cadcatcam/caudalimetroO2_velarde/caudalimetro_principal.SLDASM

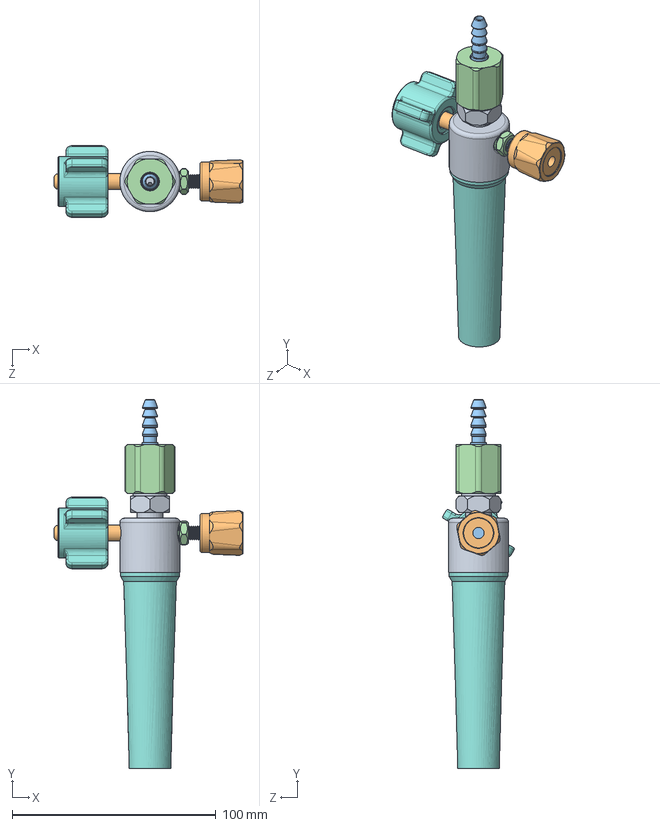
[picture p5: CAD file, 2025-07-04]
caudalimetro_principal.SLDASM
92.7 x 181.0 x 35.1 mm
Cuerpo central
Cilindro de conexión entrada
Cilindro de conexión salida
Tuerca capuchón salida
Cilindro interno
Tapa ahujereada cilindros
esfera
Cilindro exterior
Oring grande
tuerca_valvula
tornillo_perilla_válvula
tuerca_de_perilla_valvula
Niple perilla
vastago_asiento_perilla_válvula
Oring chico x 3
Tuerca conexión alimentador
