cadcatcam/caudalimetroO2_velarde/Perilla reguladora.SLDASM

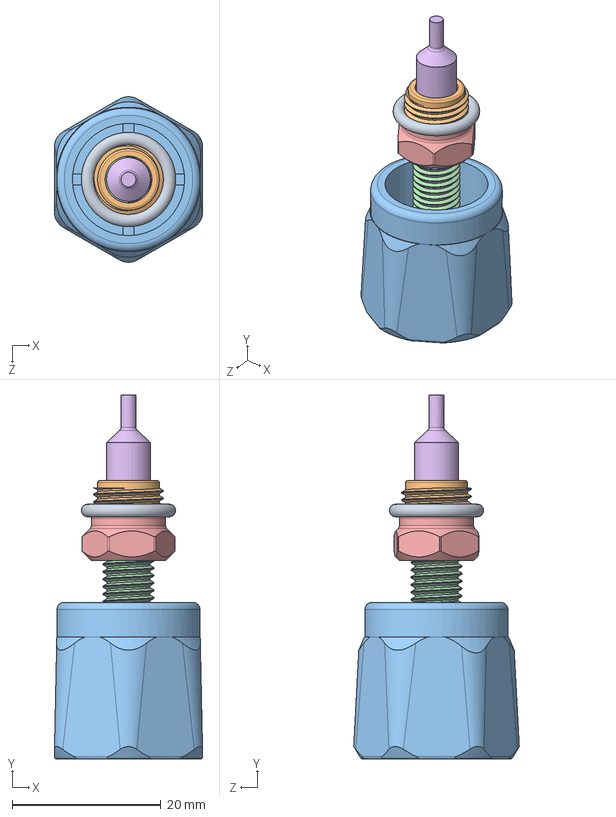
[picture p6: CAD file, 2025-07-04]
Perilla reguladora.SLDASM
20.0 x 49.0 x 22.3 mm
tuerca_valvula
tornillo_perilla_válvula
tuerca_de_perilla_valvula
Niple perilla
vastago_asiento_perilla_válvula
Oring chico
