cadcatcam/caudalimetroO2_velarde/Ensamblaje de cilindros.SLDASM

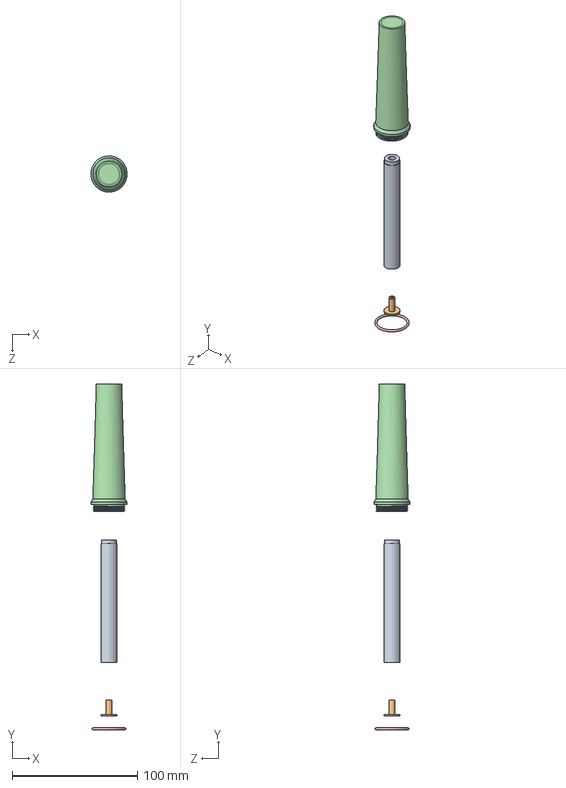
[picture p7: CAD file, 2025-07-04]
Ensamblaje de cilindros.SLDASM
29.0 x 276.0 x 29.0 mm
Cilindro interno
Tapa ahujereada cilindros
esfera
Cilindro exterior
Oring grande
