cadcatcam/caudalimetroO2_velarde/Cilindro de conexión entrada.SLDPRT

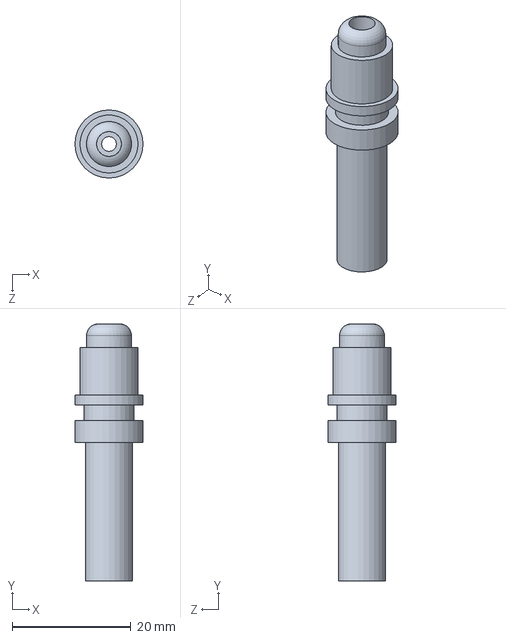
[picture p8: CAD file, 2025-07-04]
Cilindro de conexión entrada.SLDPRT
11.5 x 43.4 x 11.5 mm
