cadcatcam/caudalimetroO2_velarde/Cilindro de conexión salida.SLDPRT

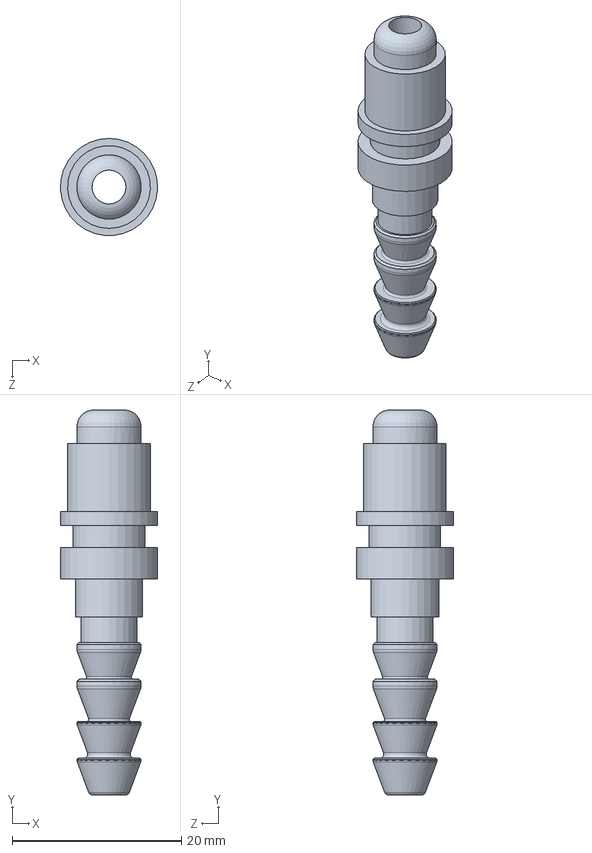
[picture p9: CAD file, 2025-07-04]
Cilindro de conexión salida.SLDPRT
11.5 x 45.5 x 11.5 mm
