cadcatcam/caudalimetroO2_velarde/tuerca_de_perilla_valvula.SLDPRT

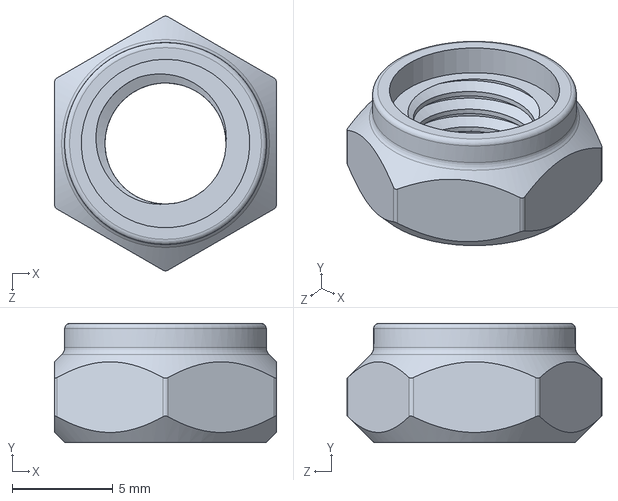
[picture p10: CAD file, 2025-07-04]
tuerca_de_perilla_valvula.SLDPRT
11.0 x 5.90 x 12.6 mm
