cadcatcam/caudalimetroO2_velarde/Oring chico.SLDPRT

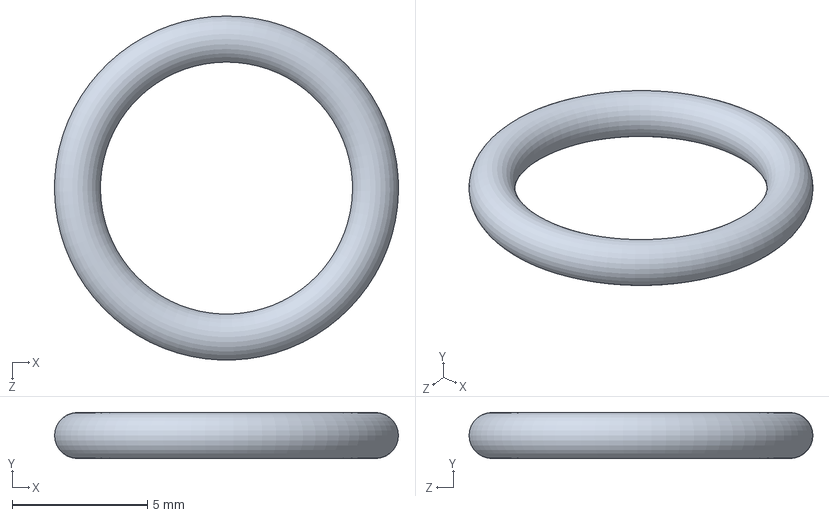
[picture p11: CAD file, 2025-07-04]
Oring chico.SLDPRT
12.7 x 1.70 x 12.7 mm
