cadcatcam/caudalimetroO2_velarde/tuerca_valvula.SLDPRT

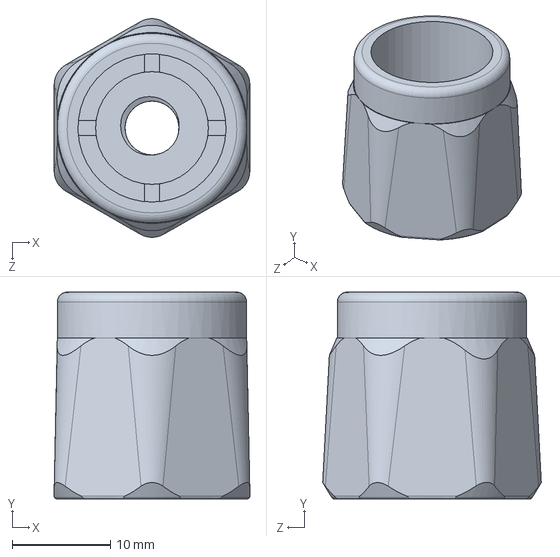
[picture p12: CAD file, 2025-07-04]
tuerca_valvula.SLDPRT
20.0 x 21.1 x 22.3 mm
