cadcatcam/caudalimetroO2_velarde/vastago_asiento_perilla_válvula.SLDPRT

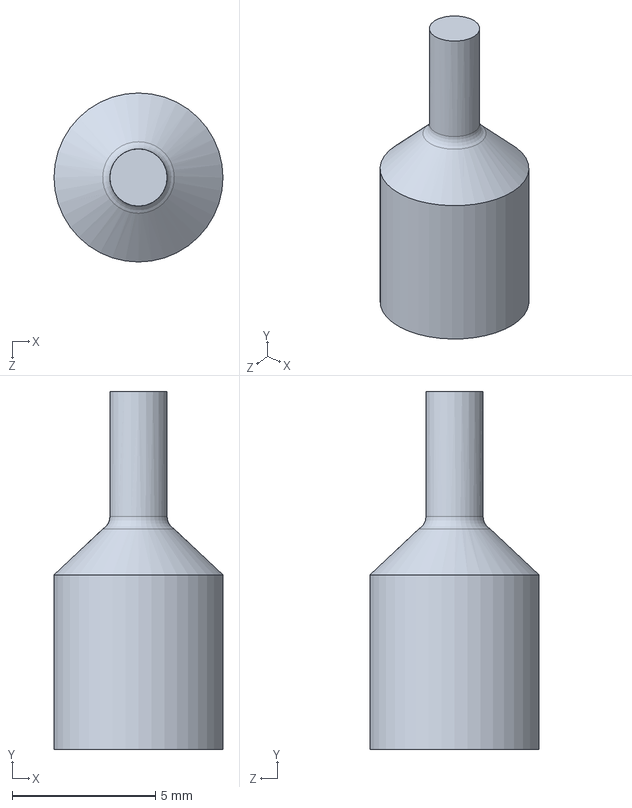
[picture p13: CAD file, 2025-07-04]
vastago_asiento_perilla_válvula.SLDPRT
5.90 x 12.5 x 5.90 mm
