cadcatcam/caudalimetroO2_velarde/Cilindro exterior.SLDPRT

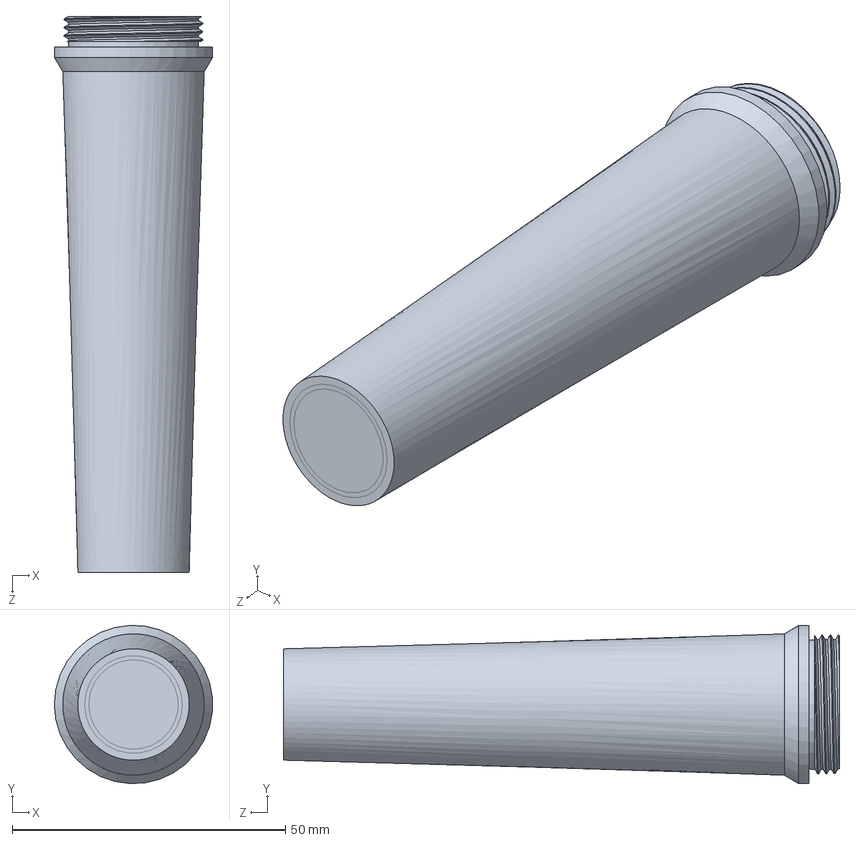
[picture p14: CAD file, 2025-07-04]
Cilindro exterior.SLDPRT
29.0 x 29.0 x 101.8 mm
