cadcatcam/caudalimetroO2_velarde/Tuerca conexión alimentador.SLDPRT

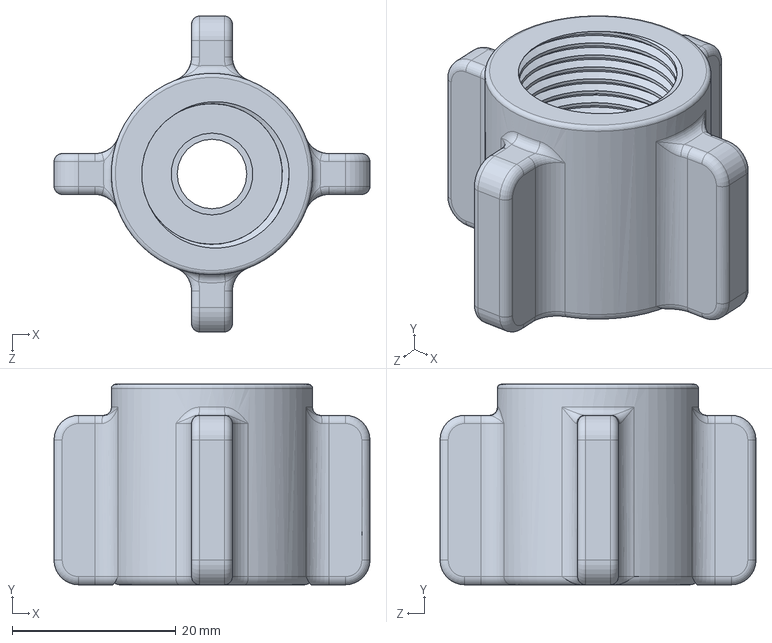
[picture p15: CAD file, 2025-07-04]
Tuerca conexión alimentador.SLDPRT
38.6 x 24.5 x 38.6 mm
