cadcatcam/caudalimetroO2_velarde/Tapa ahujereada cilindros.SLDPRT

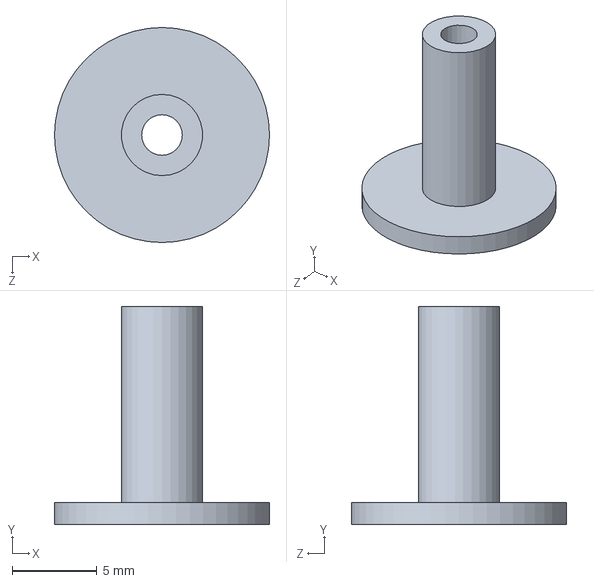
[picture p16: CAD file, 2025-07-04]
Tapa ahujereada cilindros.SLDPRT
12.7 x 12.9 x 12.7 mm
