cadcatcam/caudalimetroO2_velarde/Oring grande.SLDPRT

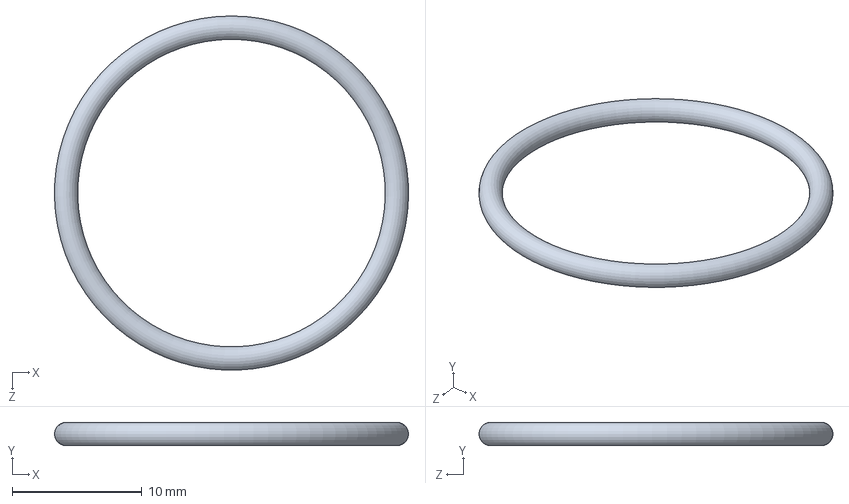
[picture p17: CAD file, 2025-07-04]
Oring grande.SLDPRT
27.3 x 1.80 x 27.3 mm
