cadcatcam/caudalimetroO2_velarde/Cuerpo central.SLDPRT

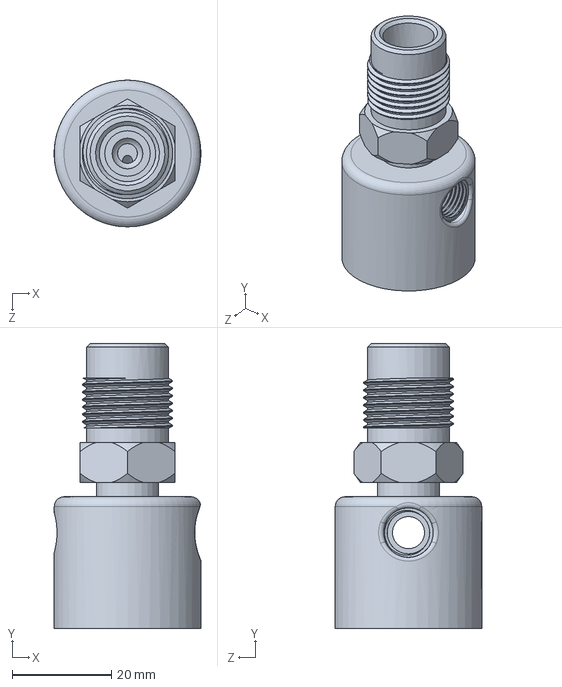
[picture p18: CAD file, 2025-07-04]
Cuerpo central.SLDPRT
29.6 x 57.5 x 29.6 mm
