cadcatcam/caudalimetroO2_velarde/Cilindro interno.SLDPRT

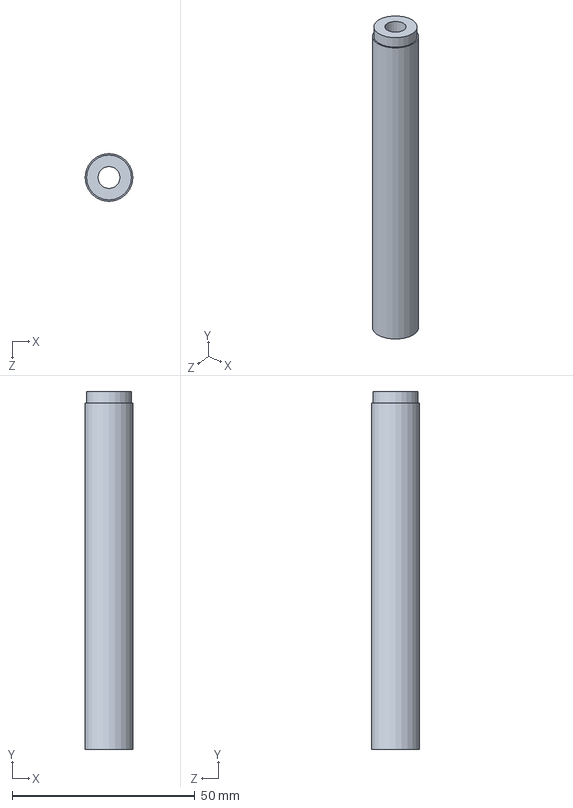
[picture p19: CAD file, 2025-07-04]
Cilindro interno.SLDPRT
13.1 x 98.0 x 13.1 mm
