cadcatcam/caudalimetroO2_velarde/Niple perilla.SLDPRT

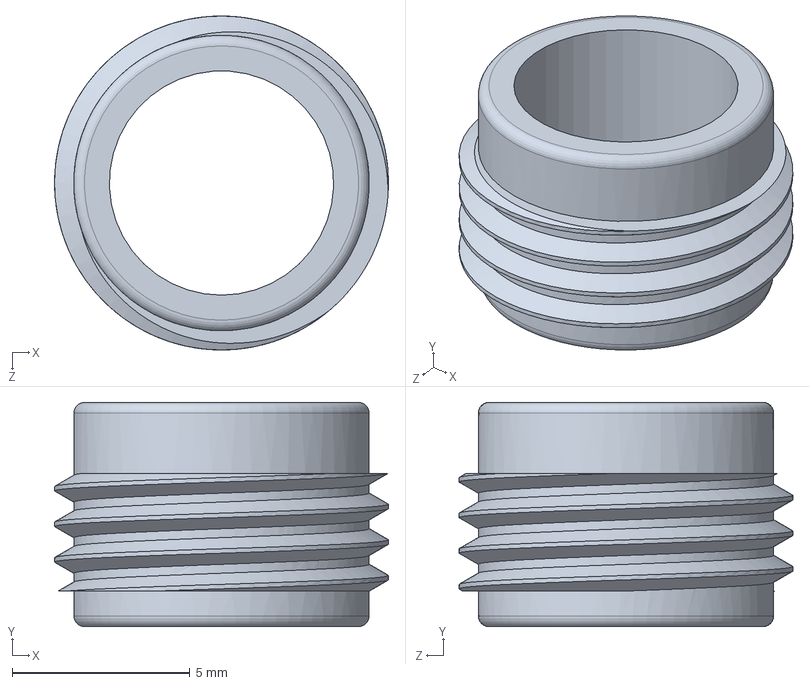
[picture p20: CAD file, 2025-07-04]
Niple perilla.SLDPRT
9.38 x 6.30 x 9.38 mm
