cadcatcam/caudalimetroO2_velarde/esfera.SLDPRT

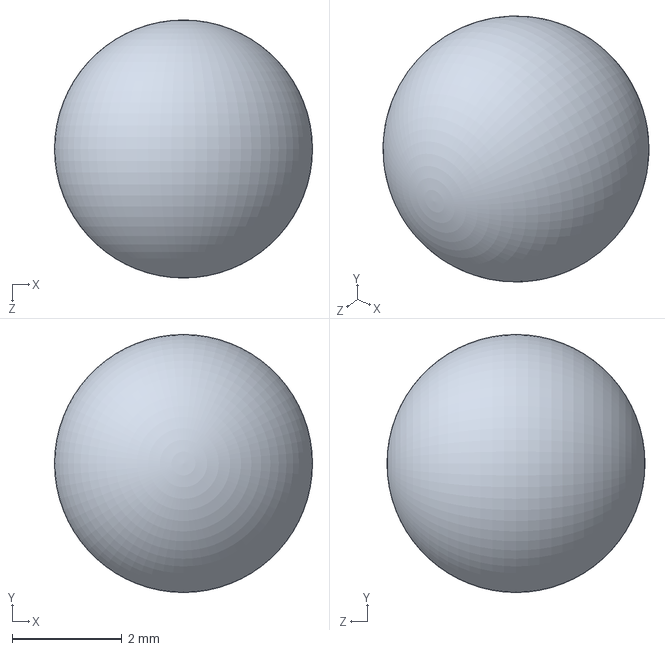
[picture p21: CAD file, 2025-07-04]
esfera.SLDPRT
4.70 x 4.70 x 4.70 mm
