cadcatcam/caudalimetroO2_velarde/Tuerca capuchón salida.SLDPRT

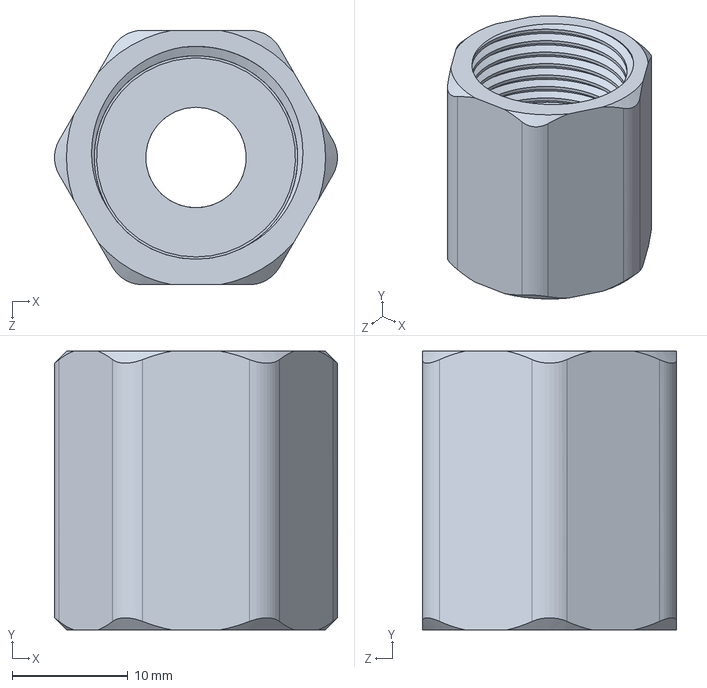
[picture p22: CAD file, 2025-07-04]
Tuerca capuchón salida.SLDPRT
24.5 x 24.1 x 22.0 mm
