cadcatcam/caudalimetroO2_velarde/tornillo_perilla_válvula.SLDPRT

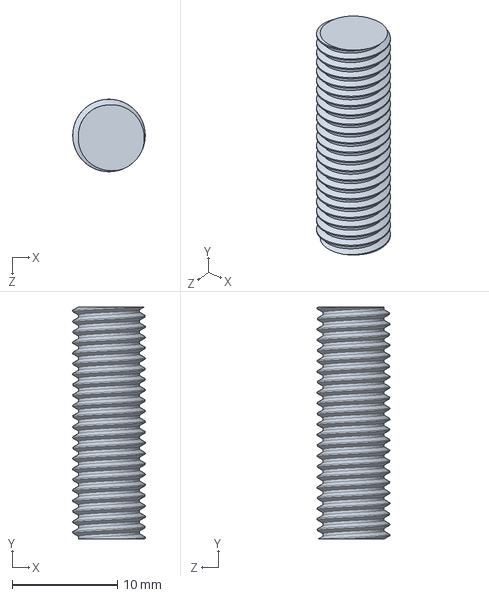
[picture p23: CAD file, 2025-07-04]
tornillo_perilla_válvula.SLDPRT
6.88 x 22.0 x 6.88 mm
