cadcatcam/caudalimetroO2_velarde/tuerca_externa_con_nervios.SLDPRT

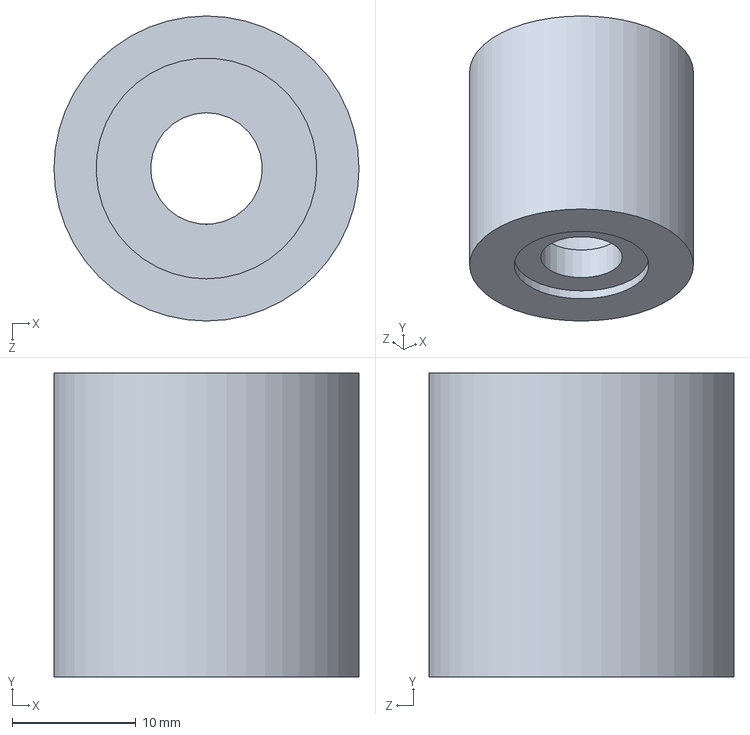
[picture p24: CAD file, 2025-06-27]
tuerca_externa_con_nervios.SLDPRT
24.6 x 24.5 x 24.6 mm
