cadcatcam/caudalimetroO2_velarde/tuerca_capuchon_v2_2020.SLDPRT

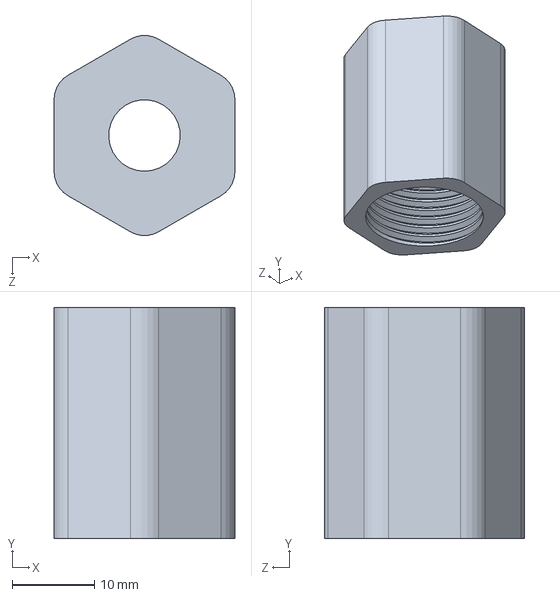
[picture p25: CAD file, 2025-05-26]
tuerca_capuchon_v2_2020.SLDPRT
22.0 x 28.1 x 24.3 mm
