cadcatcam/caudalimetroO2_velarde/tuerca_capuchon.SLDPRT

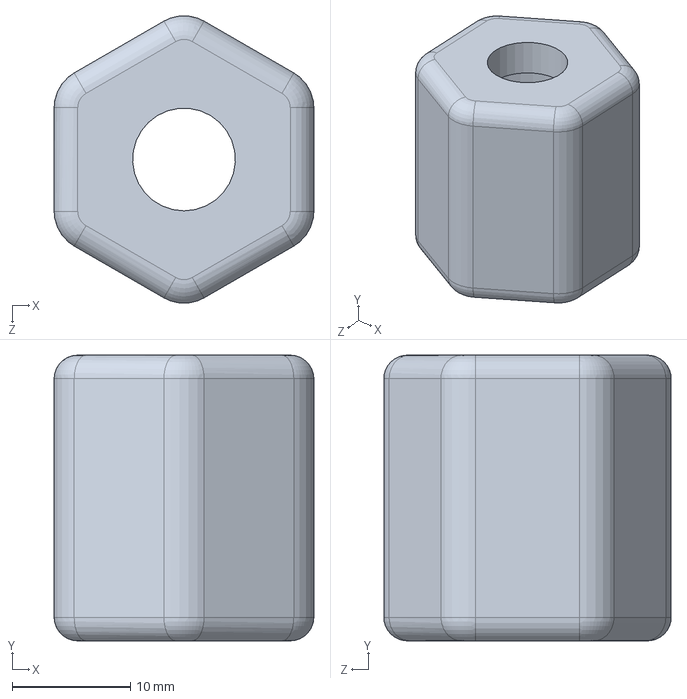
[picture p26: CAD file, 2025-05-23]
tuerca_capuchon.SLDPRT
22.0 x 24.2 x 24.3 mm
