cadcatcam/caudalimetroO2_velarde/oring.SLDPRT

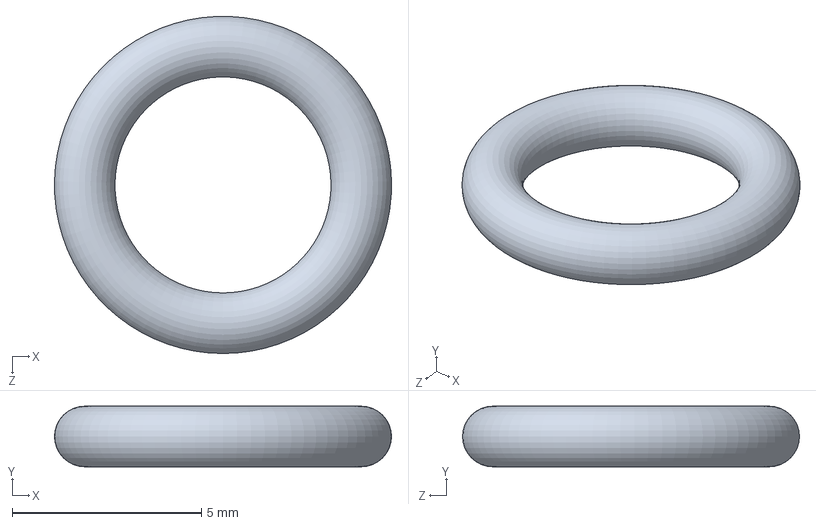
[picture p27: CAD file, 2025-04-24]
oring.SLDPRT
8.90 x 1.60 x 8.90 mm
