cadcatcam/caudalimetroO2_velarde/tapon.SLDPRT

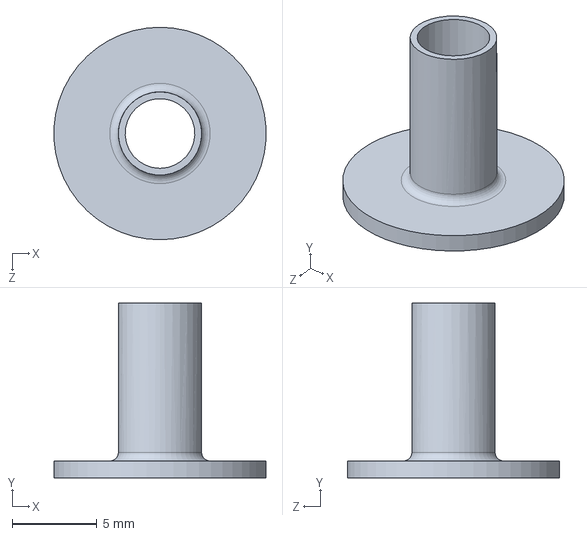
[picture p28: CAD file, 2025-04-24]
tapon.SLDPRT
12.5 x 10.3 x 12.5 mm
