cadcatcam/caudalimetroO2_velarde/Esfera_2020.SLDPRT

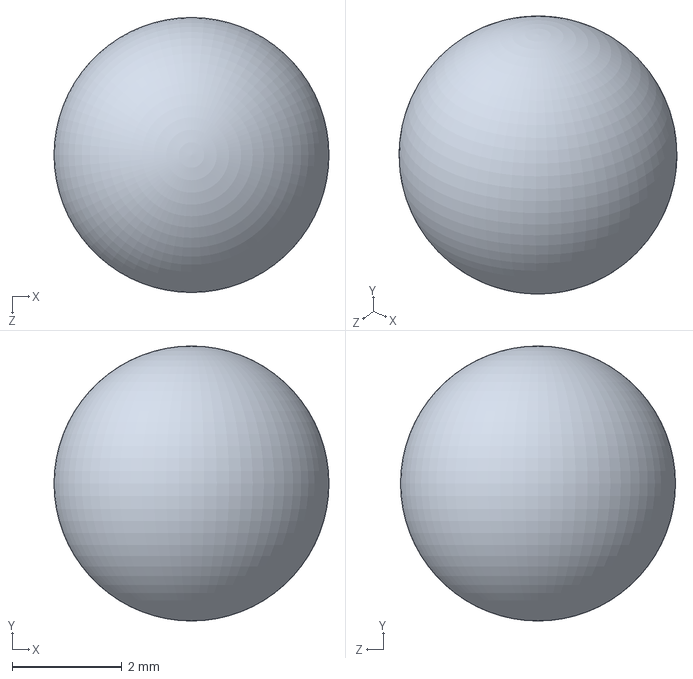
[picture p29: CAD file, 2025-04-24]
Esfera_2020.SLDPRT
5.00 x 5.00 x 5.00 mm
