cadcatcam/caudalimetroO2_velarde/(list of files, cad)

Other CAD files:
planos/caudalimetro_perilla.SLDDRW
planos/caudalimetro_principal.SLDDRW
planos/cilindro_interno.SLDDRW
planos/cilindro_rosca_externa_perilla_válvula.SLDDRW
planos/esfera_2018.SLDDRW
planos/oring_chico.SLDDRW
planos/tapon_2018.SLDDRW
planos/vastago_asiento_perilla_válvula.SLDDRW
