cadcatcam/caudalimetroO2_velarde/planos/caudalimetro_principal_muchas_hojas.pdf

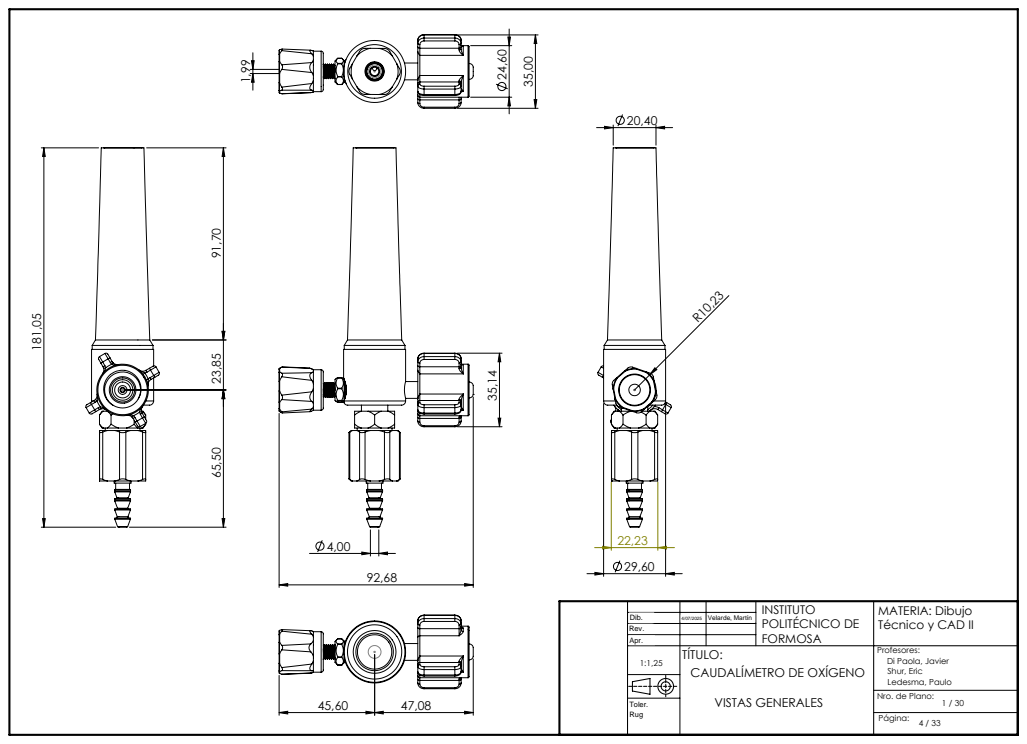
[picture p30: page 1]
POLITÉCNICO DE

MATERIA: Dibujo
Técnico y CAD II

CAUDALÍMETRO DE OXÍGENO
VISTAS GENERALES

Di Paola, Javier
Shur, Eric
Ledesma, Paulo
Nro. de Plano:

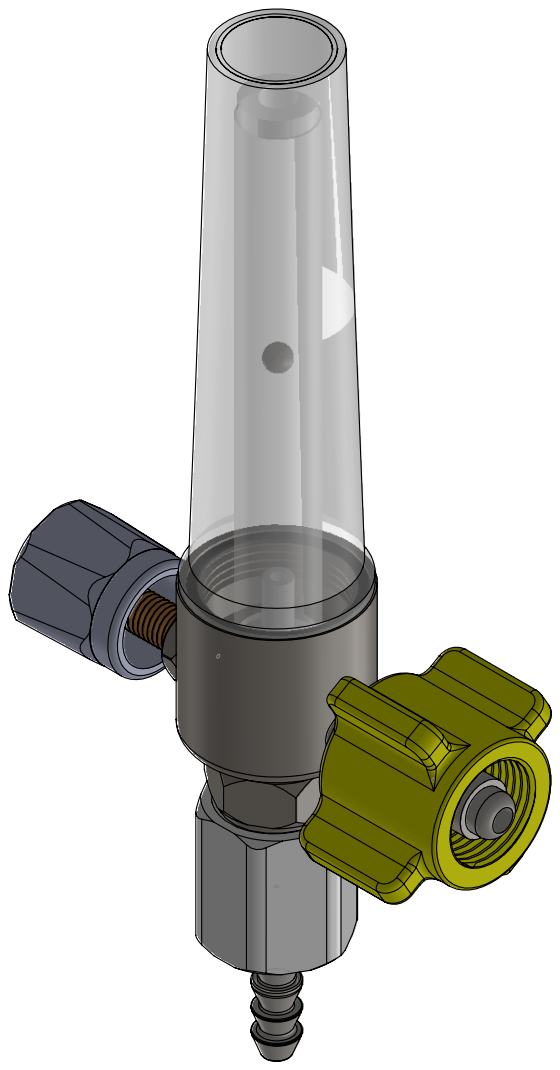
[picture p31: page 2]
POLITÉCNICO DE

MATERIA: Dibujo
Técnico y CAD II

CAUDALÍMETRO DE OXÍGENO
PERSPECTIVA GENERAL 1

Di Paola, Javier
Shur, Eric
Ledesma, Paulo
Nro. de Plano:

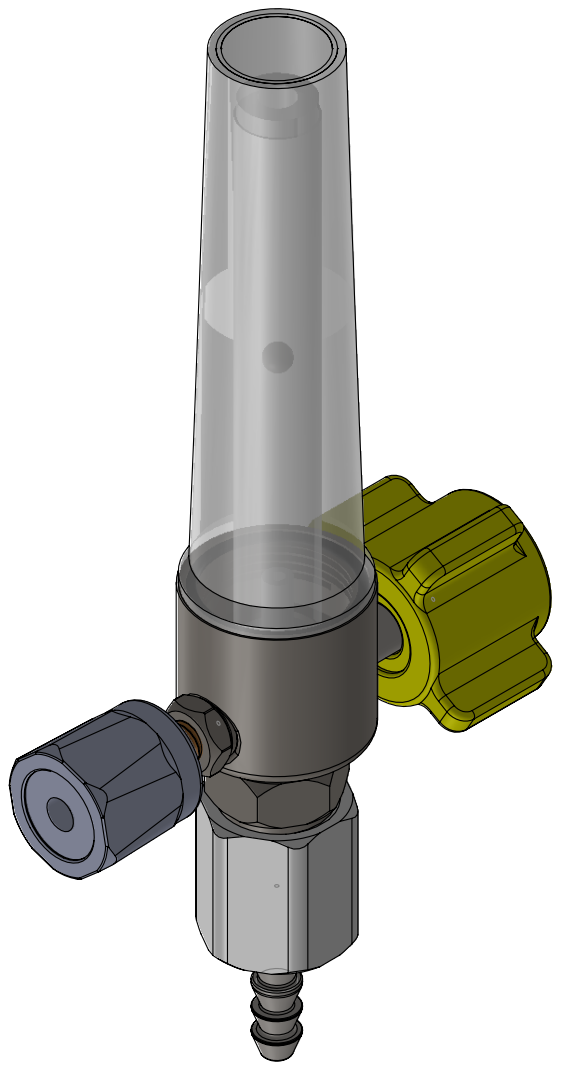
[picture p32: page 3]
POLITÉCNICO DE

MATERIA: Dibujo
Técnico y CAD II

CAUDALÍMETRO DE OXÍGENO
PERSPECTIVA GENERAL 2

Di Paola, Javier
Shur, Eric
Ledesma, Paulo
Nro. de Plano:

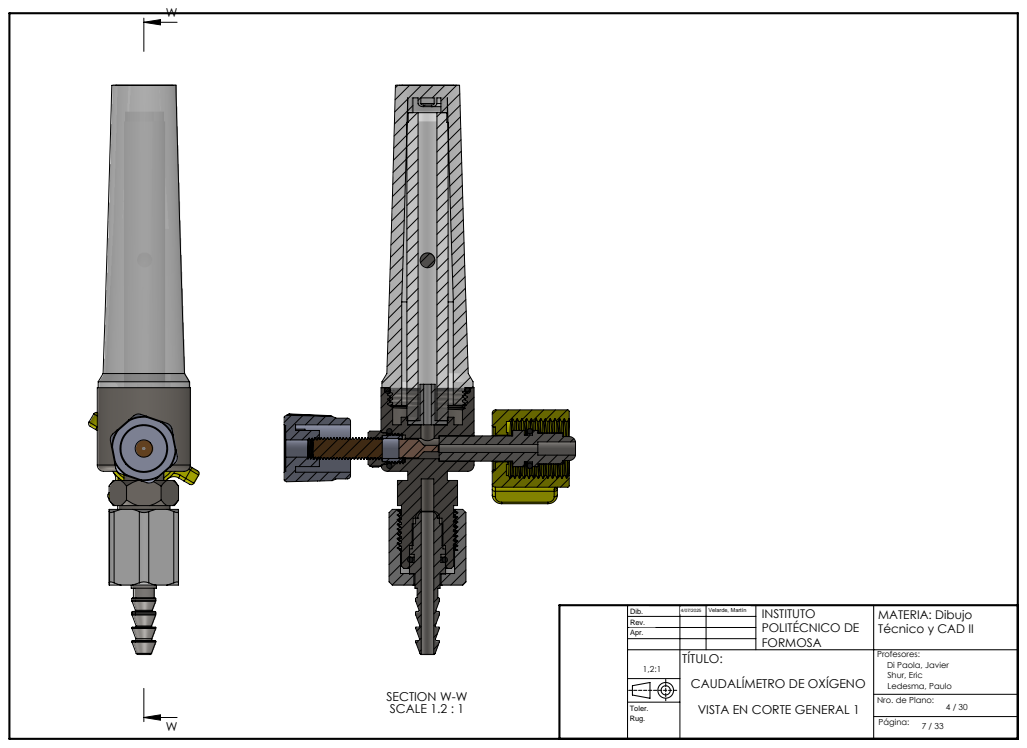
[picture p33: page 4]
SECTION W-W; SCALE 1.2 : 1; VISTA EN CORTE GENERAL 1; POLITÉCNICO DE

MATERIA: Dibujo
Técnico y CAD II

CAUDALÍMETRO DE OXÍGENO

Di Paola, Javier
Shur, Eric
Ledesma, Paulo
Nro. de Plano:

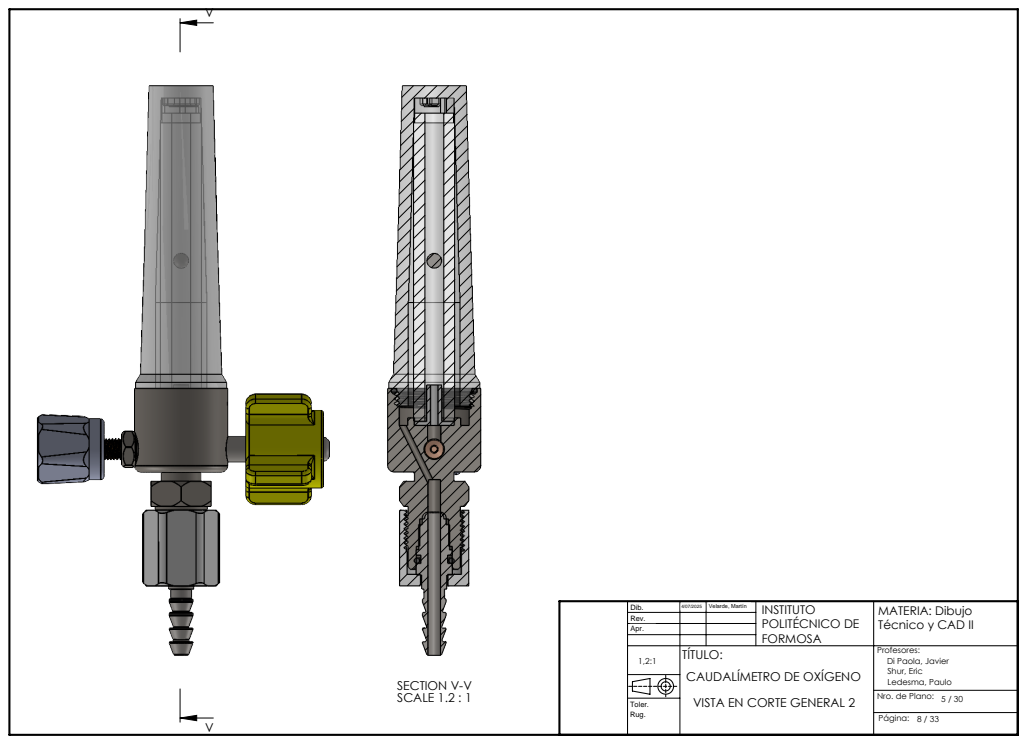
[picture p34: page 5]
SECTION V-V SCALE 1.2 : 1; POLITÉCNICO DE

MATERIA: Dibujo
Técnico y CAD II

CAUDALÍMETRO DE OXÍGENO
5 / 30 VISTA EN CORTE GENERAL 2

Di Paola, Javier
Shur, Eric
Ledesma, Paulo
Nro. de Plano:

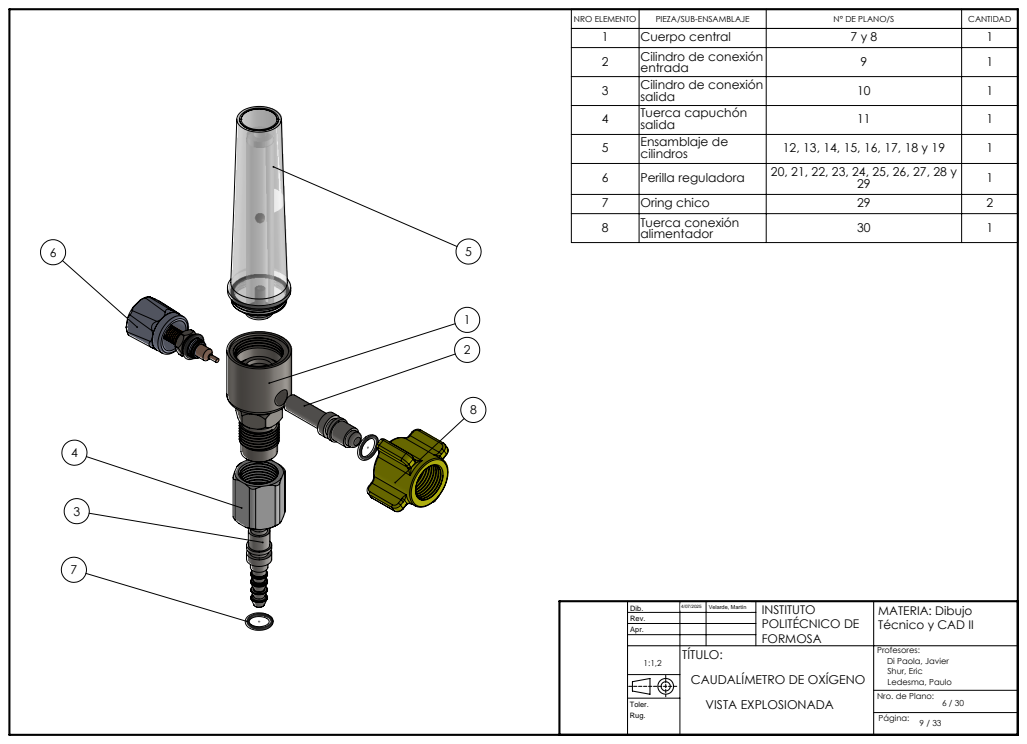
[picture p35: page 6]
POLITÉCNICO DE

NRO ELEMENTO | PIEZA/SUB-ENSAMBLAJE | N° DE PLANO/S | CANTIDAD
1 | Cuerpo central | 7 y 8 | 1
2 | Cilindro de conexión entrada | 9 | 1
3 | Cilindro de conexión salida | 10 | 1
4 | Tuerca capuchón salida | 11 | 1
5 | Ensamblaje de cilindros | 12, 13, 14, 15, 16, 17, 18 y 19 | 1
6 | Perilla reguladora | 20, 21, 22, 23, 24, 25, 26, 27, 28 y 29 | 1
7 | Oring chico | 29 | 2
8 | Tuerca conexión alimentador | 30 | 1

MATERIA: Dibujo
Técnico y CAD II

CAUDALÍMETRO DE OXÍGENO
VISTA EXPLOSIONADA

Di Paola, Javier
Shur, Eric
Ledesma, Paulo
Nro. de Plano:

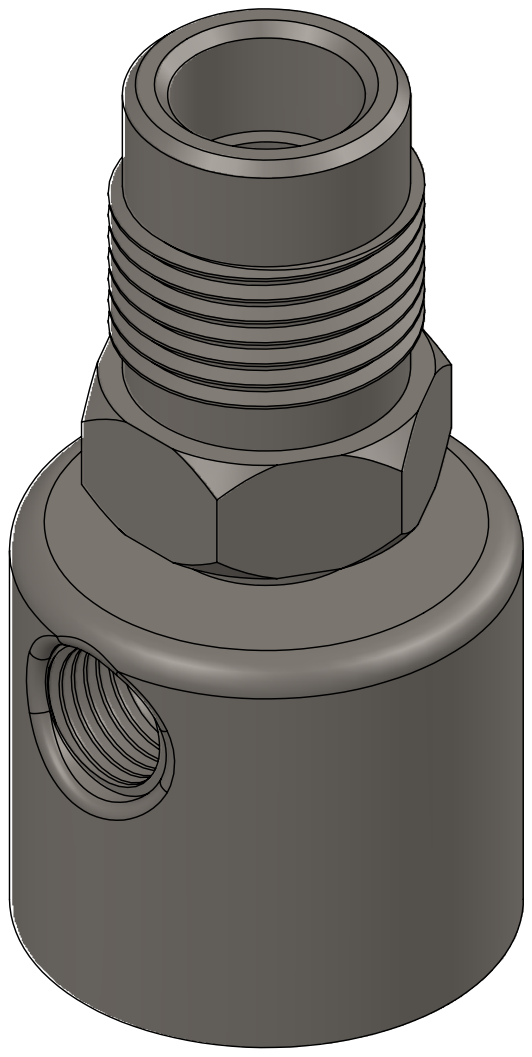
[picture p36: page 7]
CUERPO CENTRAL; POLITÉCNICO DE

MATERIA: Dibujo
Técnico y CAD II

Di Paola, Javier
Shur, Eric
Ledesma, Paulo
Nro. de Plano:

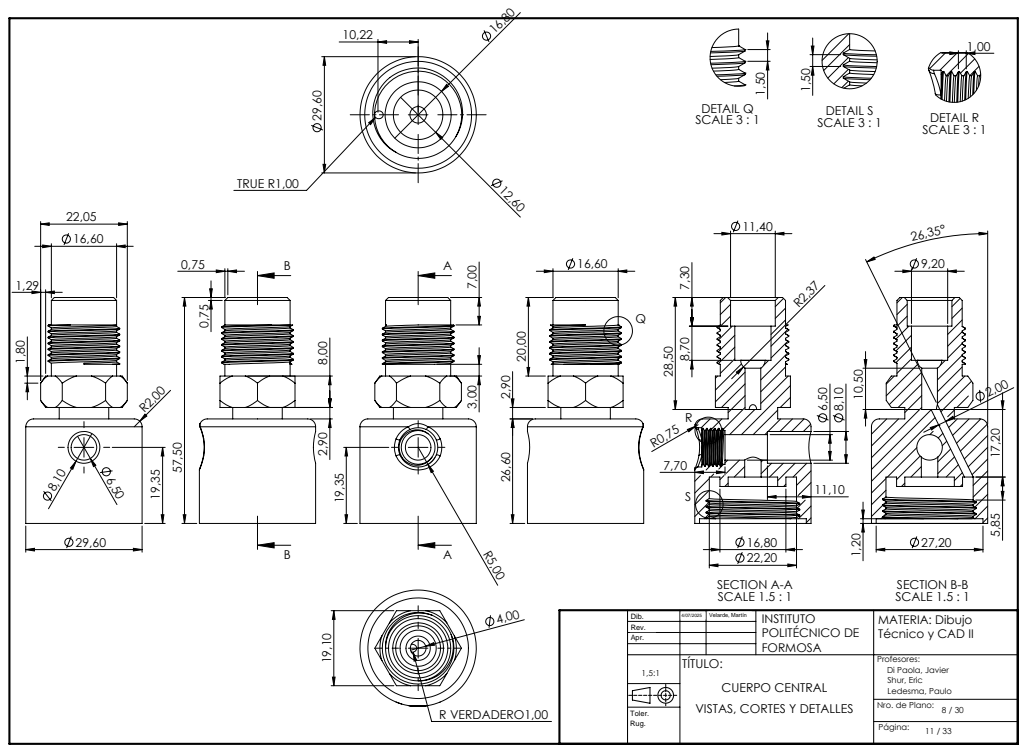
[picture p37: page 8]
TRUE R1,00; R VERDADERO1,00; SECTION A-A SCALE 1.5 : 1; DETAIL Q SCALE 3 : 1; DETAIL R SCALE 3 : 1; DETAIL S SCALE 3 : 1; POLITÉCNICO DE

SECTION B-B
SCALE 1.5 : 1
MATERIA: Dibujo
Técnico y CAD II

CUERPO CENTRAL
VISTAS, CORTES Y DETALLES

Di Paola, Javier
Shur, Eric
Ledesma, Paulo
Nro. de Plano:

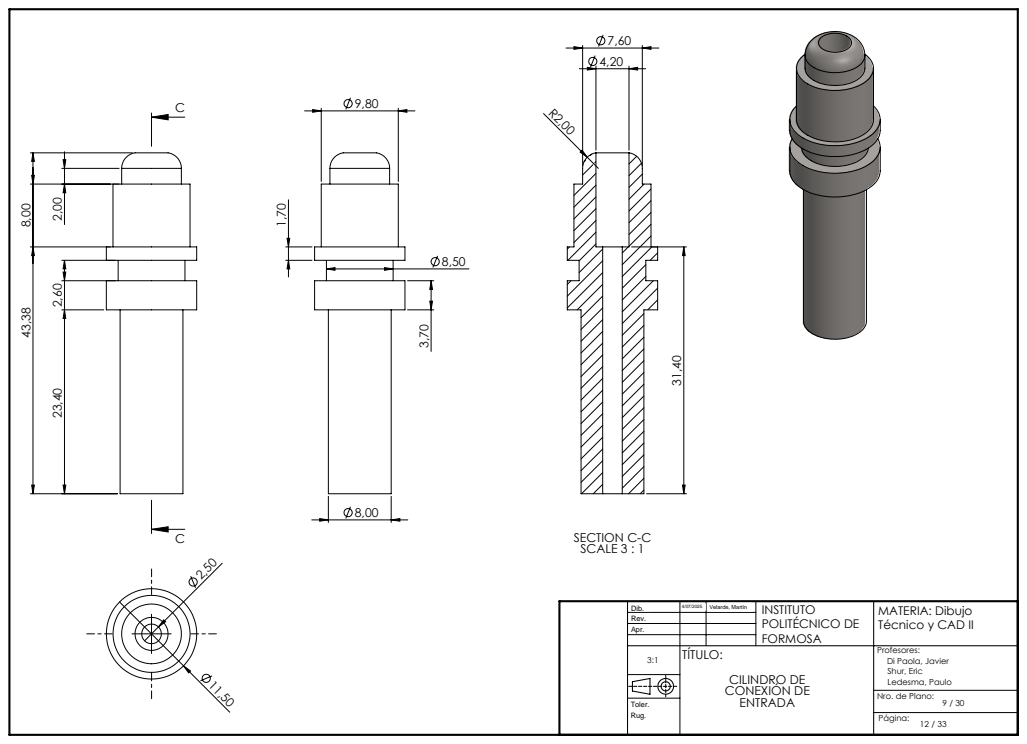
[picture p38: page 9]
SECTION C-C SCALE 3 : 1; CILINDRO DE CONEXIÓN DE; POLITÉCNICO DE

MATERIA: Dibujo
Técnico y CAD II

Di Paola, Javier
Shur, Eric
Ledesma, Paulo
Nro. de Plano:

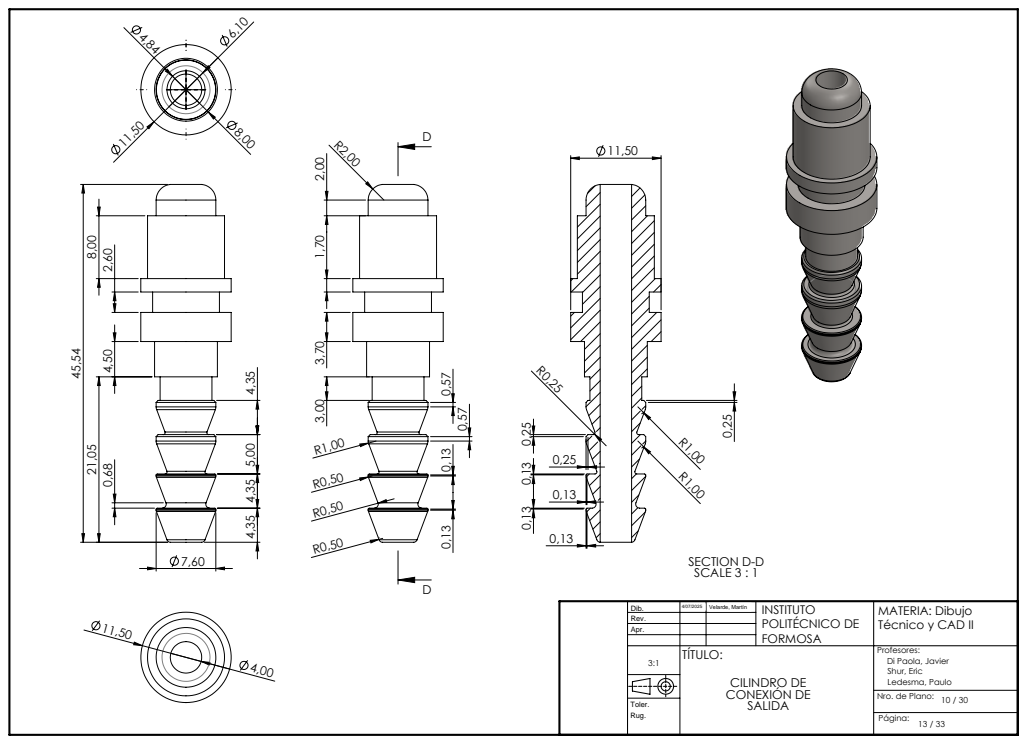
[picture p39: page 10]
SECTION D-D SCALE 3 : 1; CILINDRO DE CONEXIÓN DE; POLITÉCNICO DE

MATERIA: Dibujo
Técnico y CAD II

Di Paola, Javier
Shur, Eric
Ledesma, Paulo
Nro. de Plano:

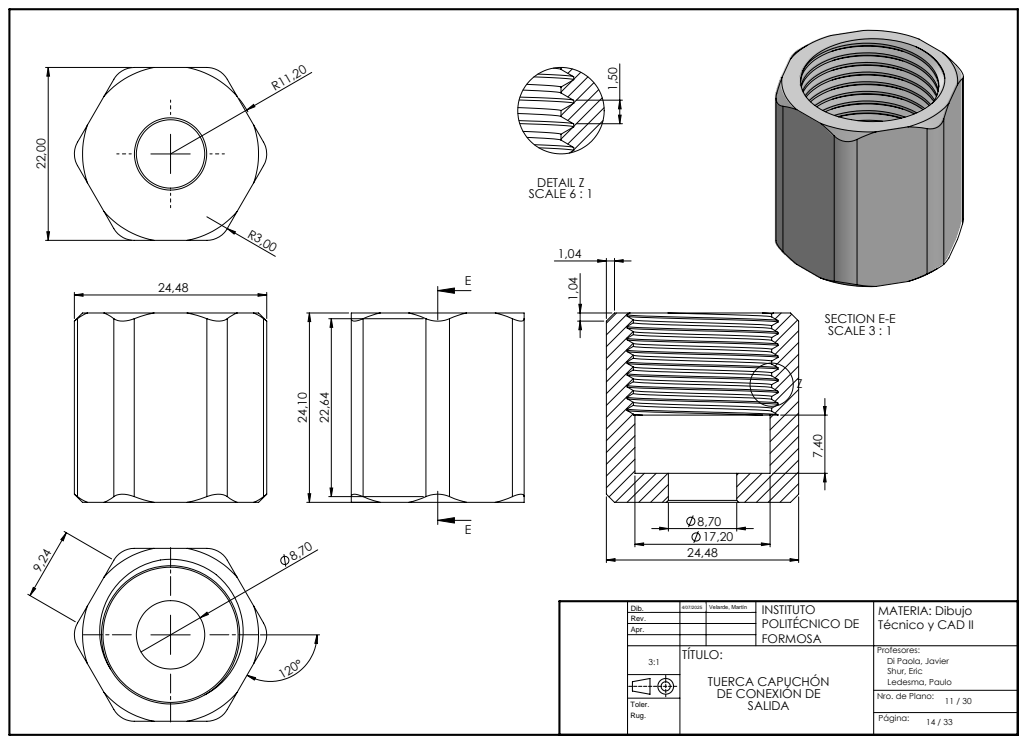
[picture p40: page 11]
SECTION E-E SCALE 3 : 1; DETAIL Z SCALE 6 : 1; POLITÉCNICO DE

MATERIA: Dibujo
Técnico y CAD II

Di Paola, Javier
Shur, Eric
Ledesma, Paulo
Nro. de Plano:

TUERCA CAPUCHÓN
DE CONEXIÓN DE
SALIDA

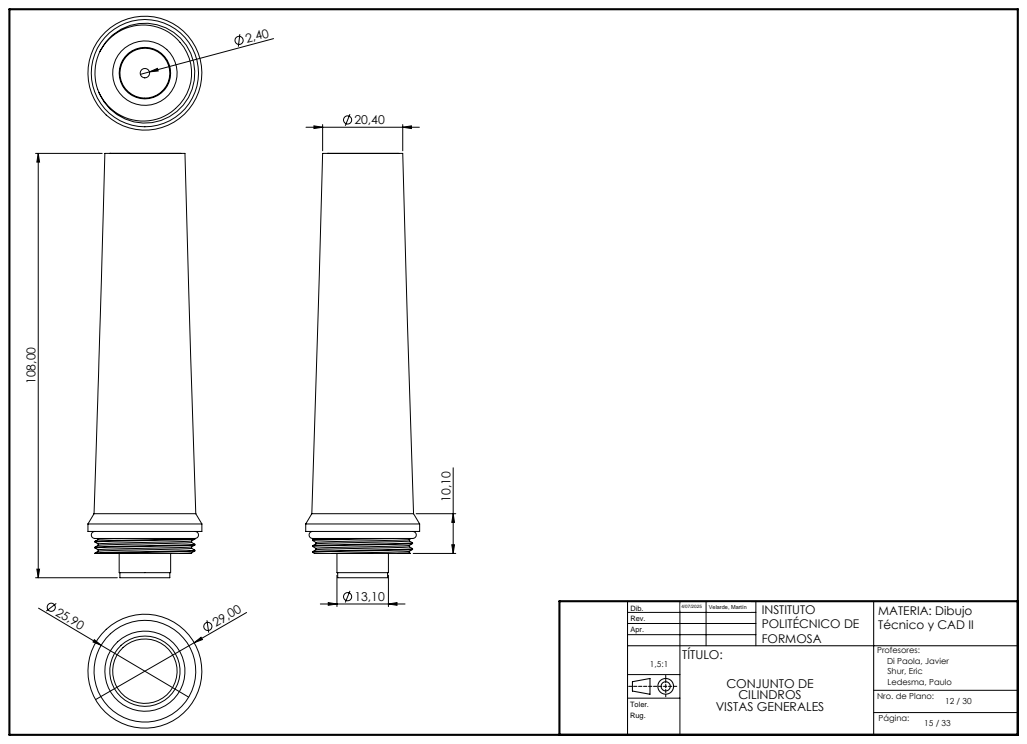
[picture p41: page 12]
CONJUNTO DE VISTAS GENERALES; POLITÉCNICO DE

MATERIA: Dibujo
Técnico y CAD II

Di Paola, Javier
Shur, Eric
Ledesma, Paulo
Nro. de Plano:

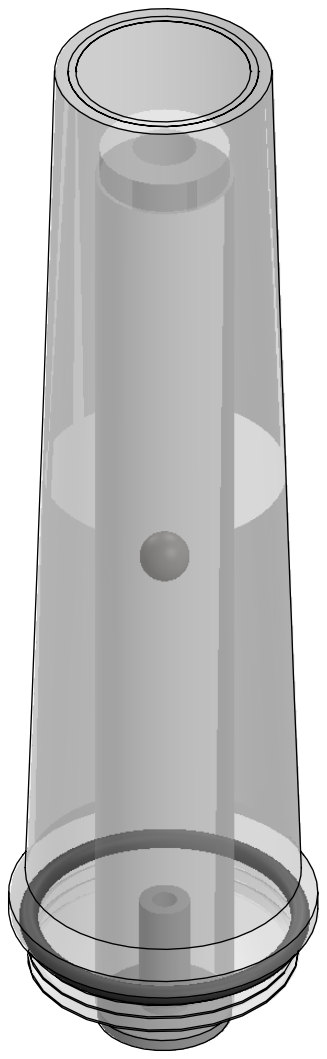
[picture p42: page 13]
CONJUNTO DE; POLITÉCNICO DE

MATERIA: Dibujo
Técnico y CAD II

Di Paola, Javier
Shur, Eric
Ledesma, Paulo
Nro. de Plano:

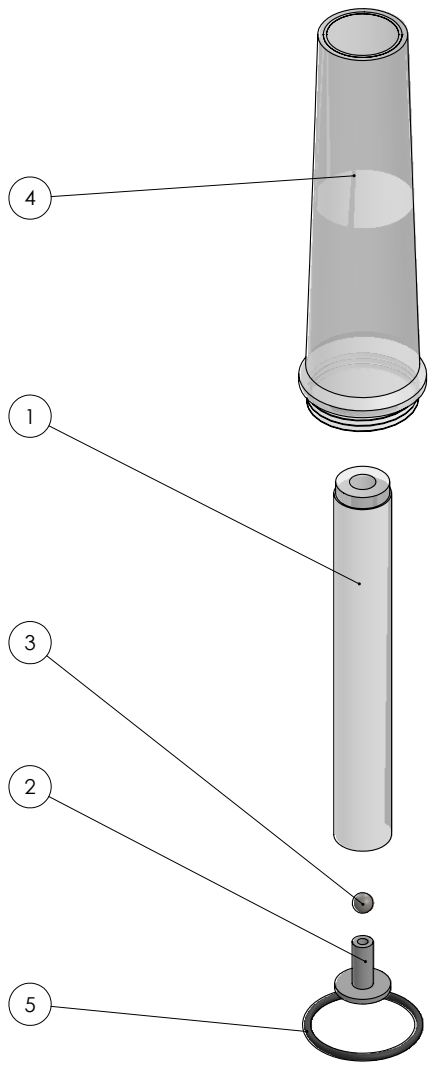
[picture p43: page 14]
CONJUNTO DE VISTA EXPLOSIONADA; POLITÉCNICO DE

NRO ELEMENTO | PIEZA/SUB-ENSAMBLAJE | N° DE PLANO/S | CANTIDAD
1 | Cilindro interno | 15 | 1
2 | Tapa ahujereada cilindros | 16 | 1
3 | Esfera | 17 | 1
4 | Cilindro exterior | 18 | 1
5 | Oring grande | 19 | 1

MATERIA: Dibujo
Técnico y CAD II

Di Paola, Javier
Shur, Eric
Ledesma, Paulo
Nro. de Plano:

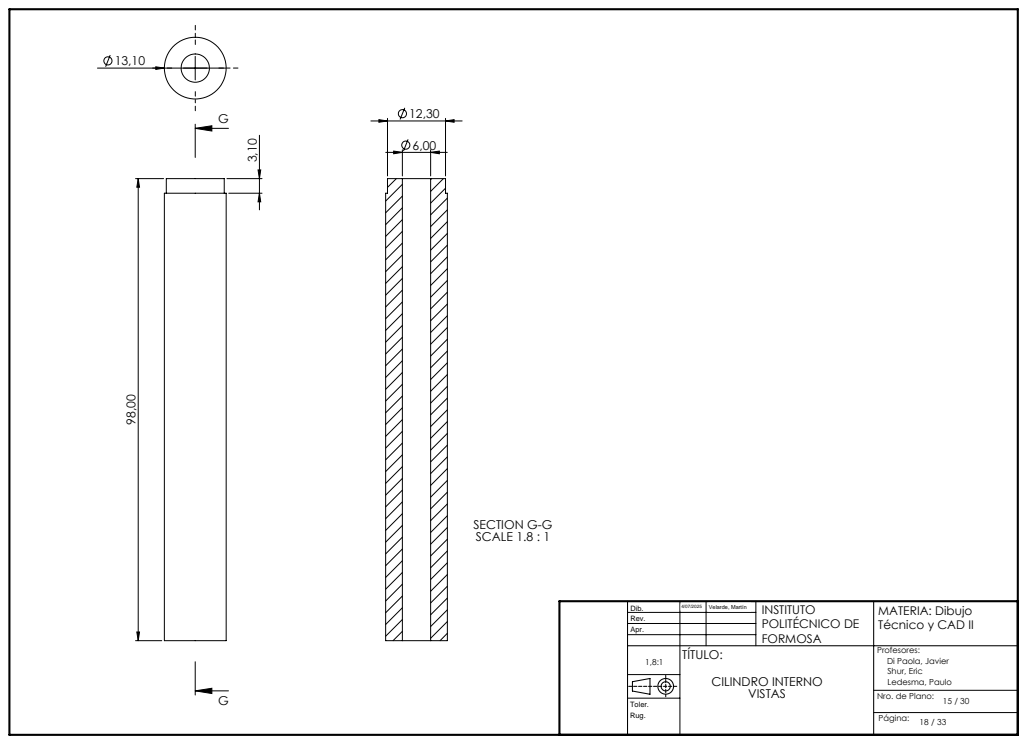
[picture p44: page 15]
SECTION G-G SCALE 1.8 : 1; CILINDRO INTERNO; POLITÉCNICO DE

MATERIA: Dibujo
Técnico y CAD II

Di Paola, Javier
Shur, Eric
Ledesma, Paulo
Nro. de Plano:

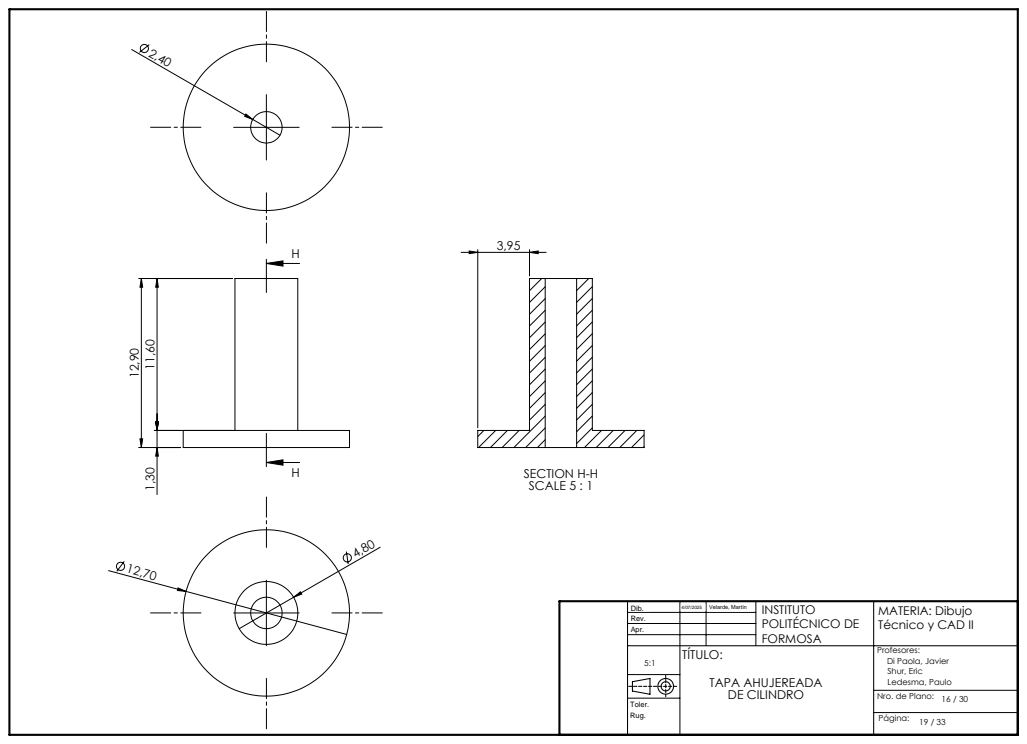
[picture p45: page 16]
SECTION H-H SCALE 5 : 1; TAPA AHUJEREADA DE CILINDRO; POLITÉCNICO DE

MATERIA: Dibujo
Técnico y CAD II

Di Paola, Javier
Shur, Eric
Ledesma, Paulo
Nro. de Plano:

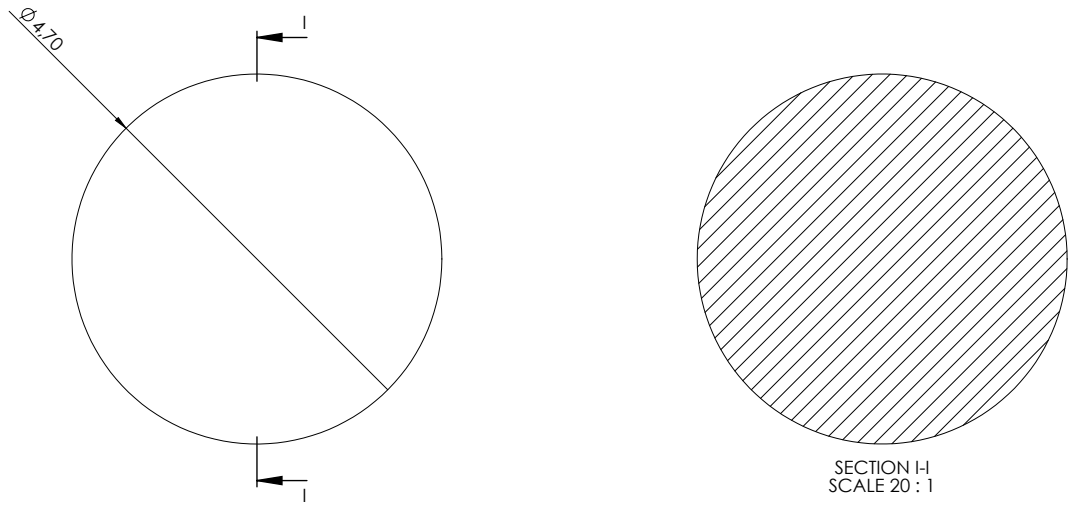
[picture p46: page 17]
SECTION I-I SCALE 20 : 1; POLITÉCNICO DE

MATERIA: Dibujo
Técnico y CAD II

Di Paola, Javier
Shur, Eric
Ledesma, Paulo
Nro. de Plano:

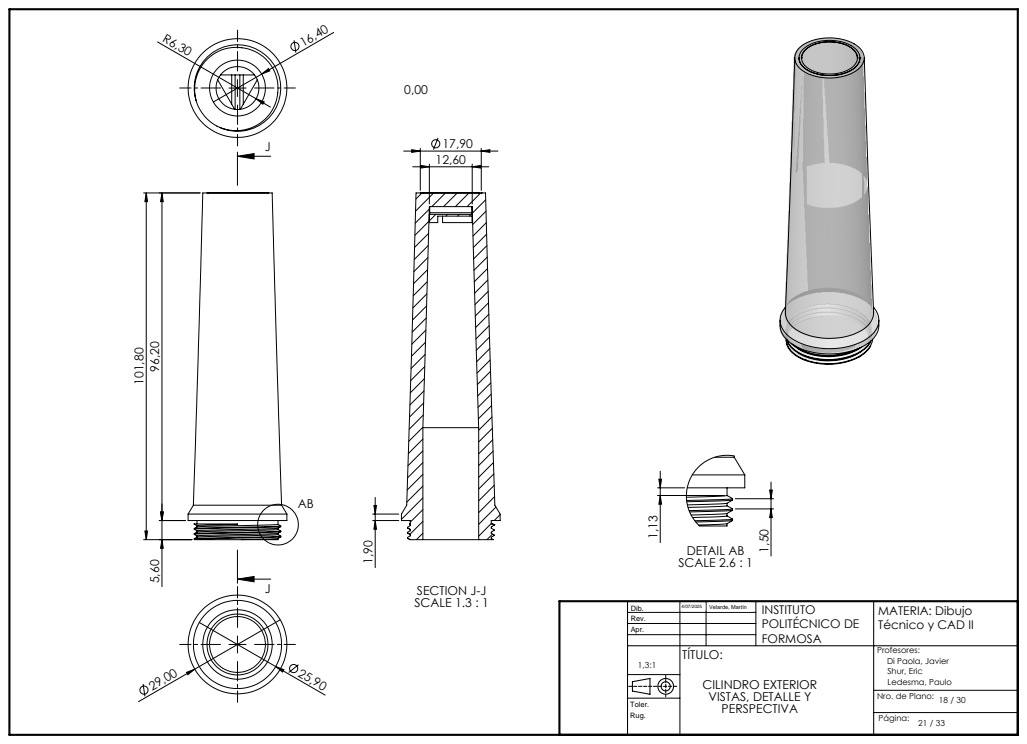
[picture p47: page 18]
SECTION J-J SCALE 1.3 : 1; DETAIL AB SCALE 2.6 : 1; CILINDRO EXTERIOR VISTAS, DETALLE Y; POLITÉCNICO DE

MATERIA: Dibujo
Técnico y CAD II

Di Paola, Javier
Shur, Eric
Ledesma, Paulo
Nro. de Plano:

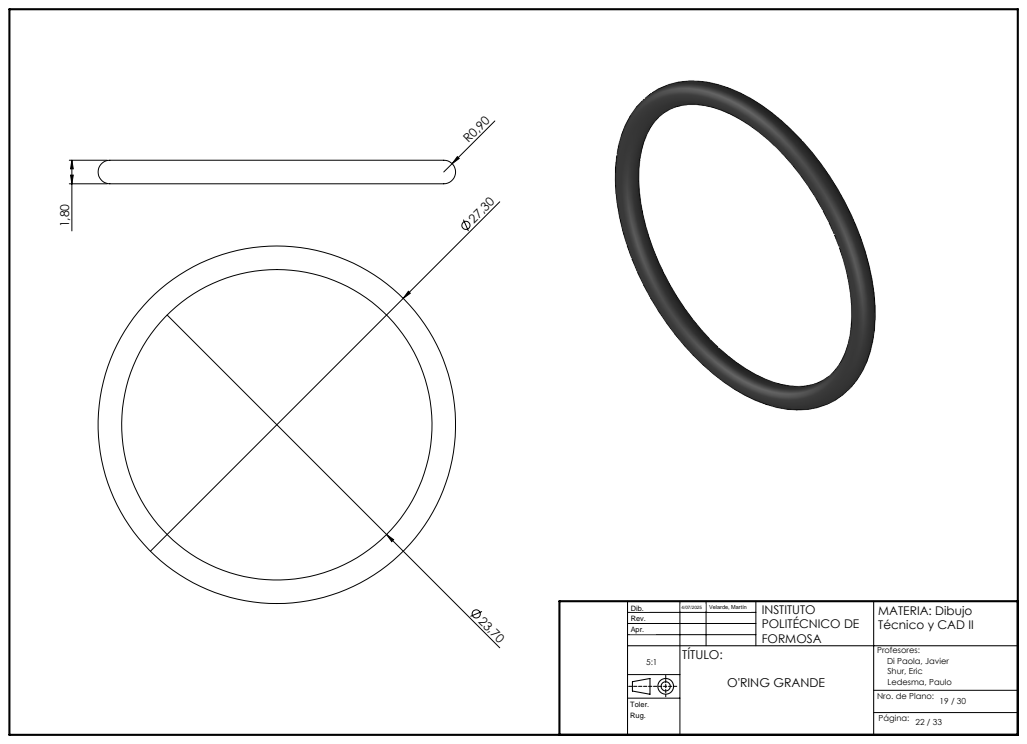
[picture p48: page 19]
O'RING GRANDE; POLITÉCNICO DE

MATERIA: Dibujo
Técnico y CAD II

Di Paola, Javier
Shur, Eric
Ledesma, Paulo
Nro. de Plano:

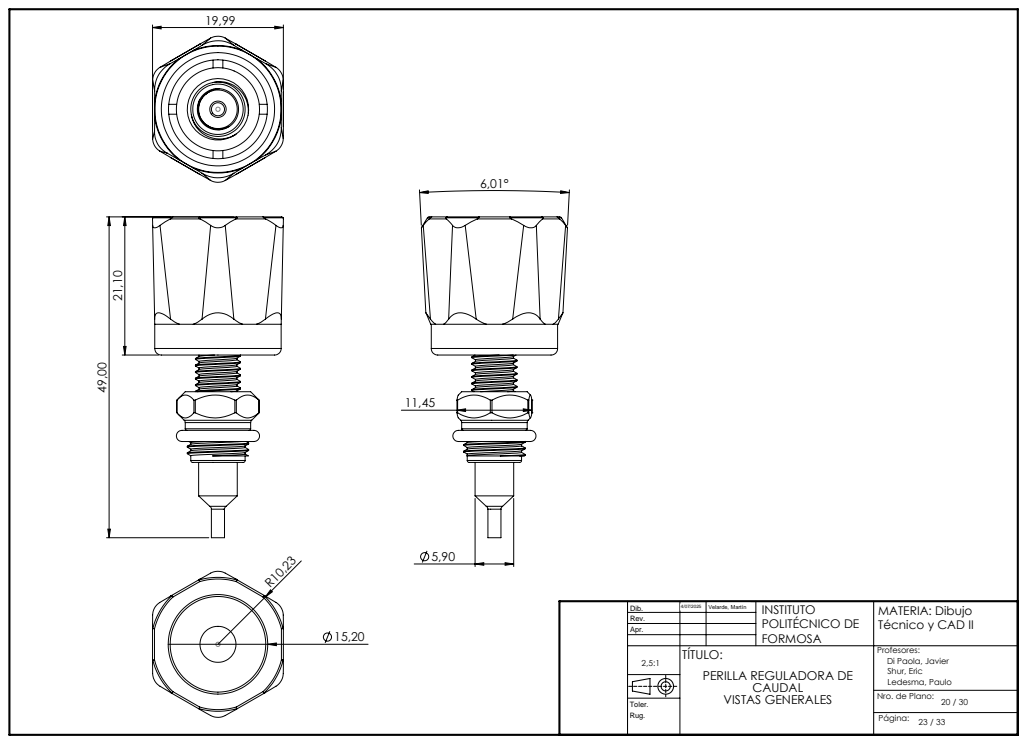
[picture p49: page 20]
POLITÉCNICO DE

MATERIA: Dibujo
Técnico y CAD II

PERILLA REGULADORA DE
CAUDAL
VISTAS GENERALES

Di Paola, Javier
Shur, Eric
Ledesma, Paulo
Nro. de Plano:

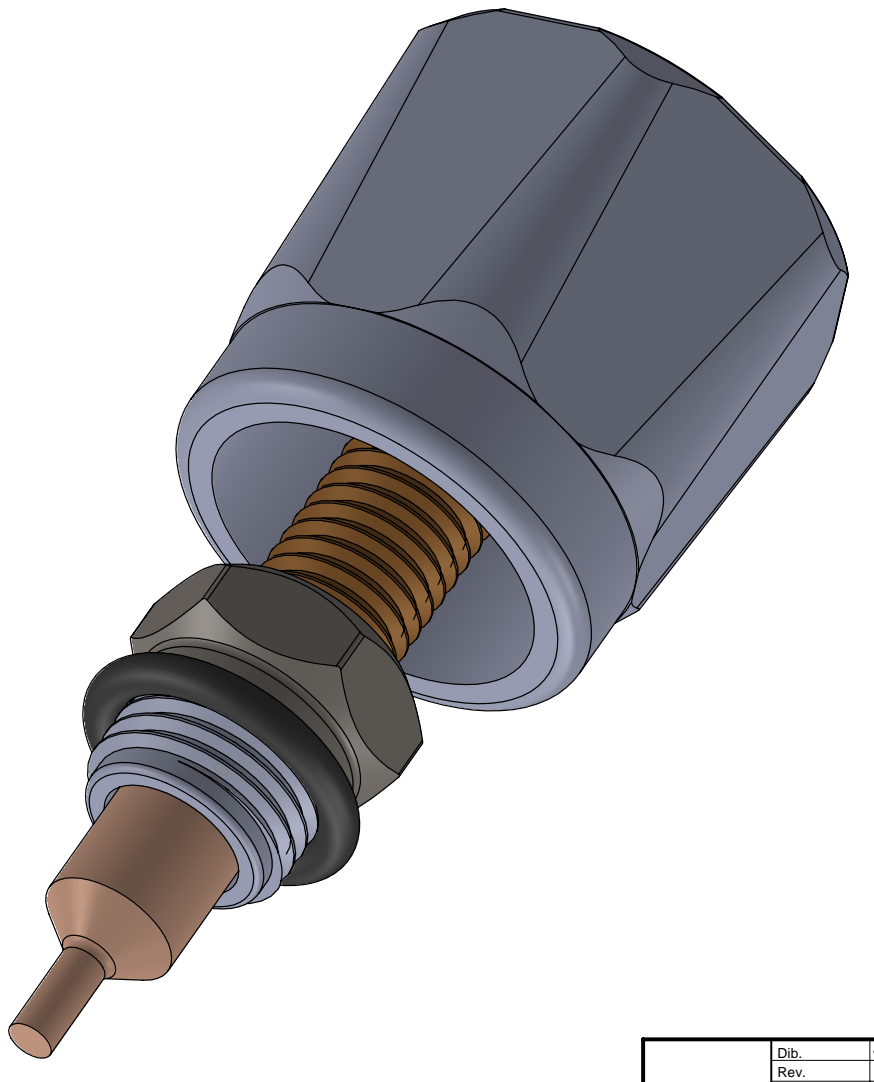
[picture p50: page 21]
POLITÉCNICO DE

MATERIA: Dibujo
Técnico y CAD II

PERILLA REGULADORA DE
CAUDAL
PERSPECTIVA 1

Di Paola, Javier
Shur, Eric
Ledesma, Paulo
Nro. de Plano:

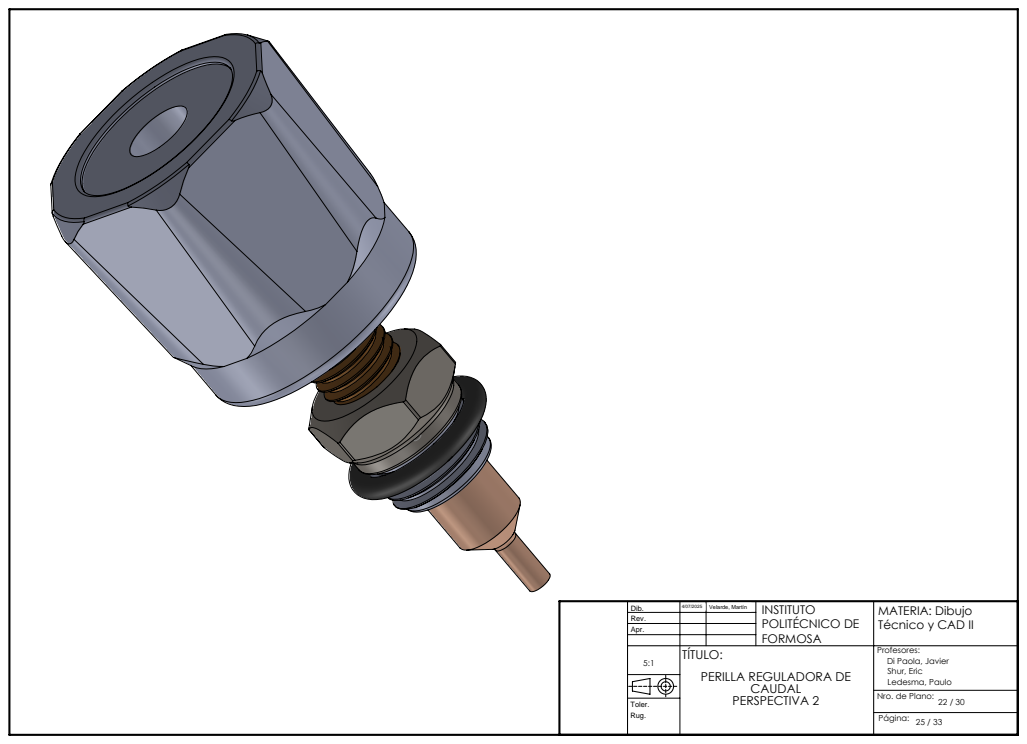
[picture p51: page 22]
POLITÉCNICO DE

MATERIA: Dibujo
Técnico y CAD II

PERILLA REGULADORA DE
CAUDAL
PERSPECTIVA 2

Di Paola, Javier
Shur, Eric
Ledesma, Paulo
Nro. de Plano:

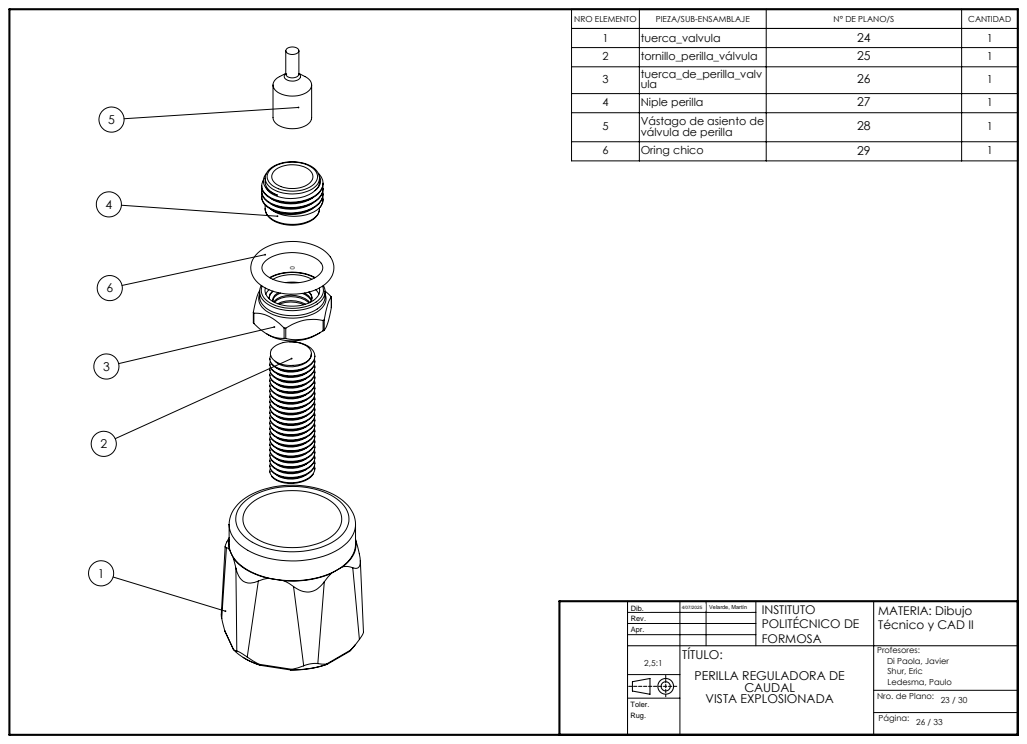
[picture p52: page 23]
POLITÉCNICO DE

NRO ELEMENTO | PIEZA/SUB-ENSAMBLAJE | N° DE PLANO/S | CANTIDAD
1 | tuerca_valvula | 24 | 1
2 | tornillo_perilla_válvula | 25 | 1
3 | tuerca_de_perilla_valv ula | 26 | 1
4 | Niple perilla | 27 | 1
5 | Vástago de asiento de válvula de perilla | 28 | 1
6 | Oring chico | 29 | 1

MATERIA: Dibujo
Técnico y CAD II

PERILLA REGULADORA DE
CAUDAL
VISTA EXPLOSIONADA

Di Paola, Javier
Shur, Eric
Ledesma, Paulo
Nro. de Plano:

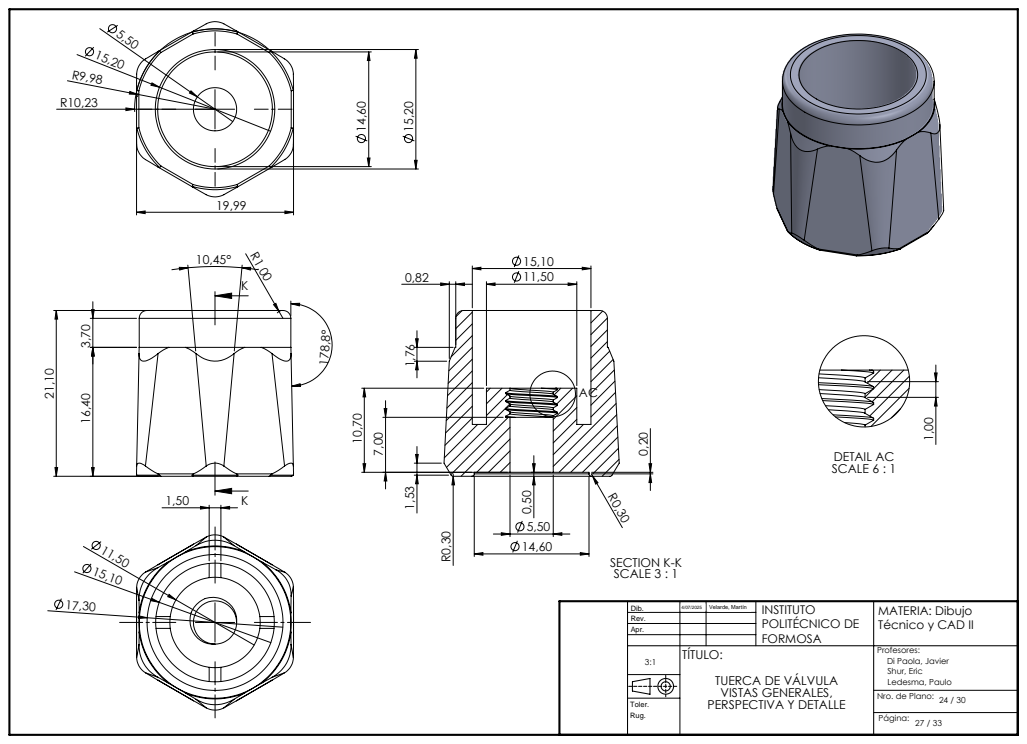
[picture p53: page 24]
SECTION K-K SCALE 3 : 1; DETAIL AC SCALE 6 : 1; POLITÉCNICO DE

MATERIA: Dibujo
Técnico y CAD II

TUERCA DE VÁLVULA
VISTAS GENERALES,
PERSPECTIVA Y DETALLE

Di Paola, Javier
Shur, Eric
Ledesma, Paulo
Nro. de Plano:

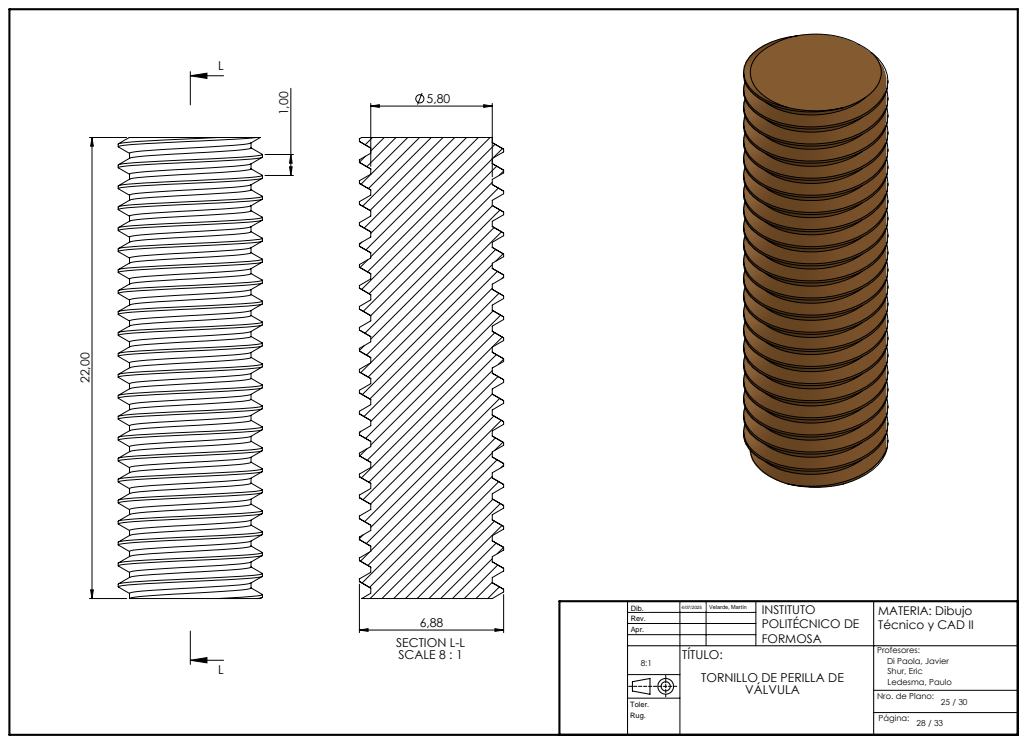
[picture p54: page 25]
SECTION L-L SCALE 8 : 1; POLITÉCNICO DE

MATERIA: Dibujo
Técnico y CAD II

TORNILLO DE PERILLA DE
VÁLVULA

Di Paola, Javier
Shur, Eric
Ledesma, Paulo
Nro. de Plano:

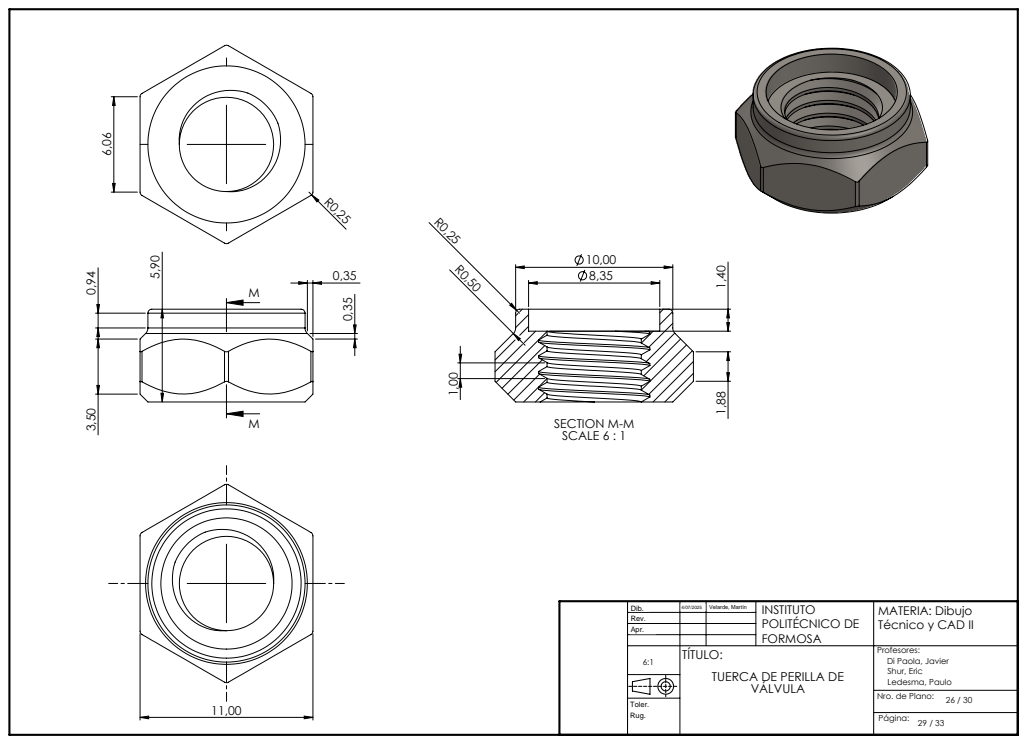
[picture p55: page 26]
SECTION M-M SCALE 6 : 1; POLITÉCNICO DE

MATERIA: Dibujo
Técnico y CAD II

TUERCA DE PERILLA DE
VÁLVULA

Di Paola, Javier
Shur, Eric
Ledesma, Paulo
Nro. de Plano:

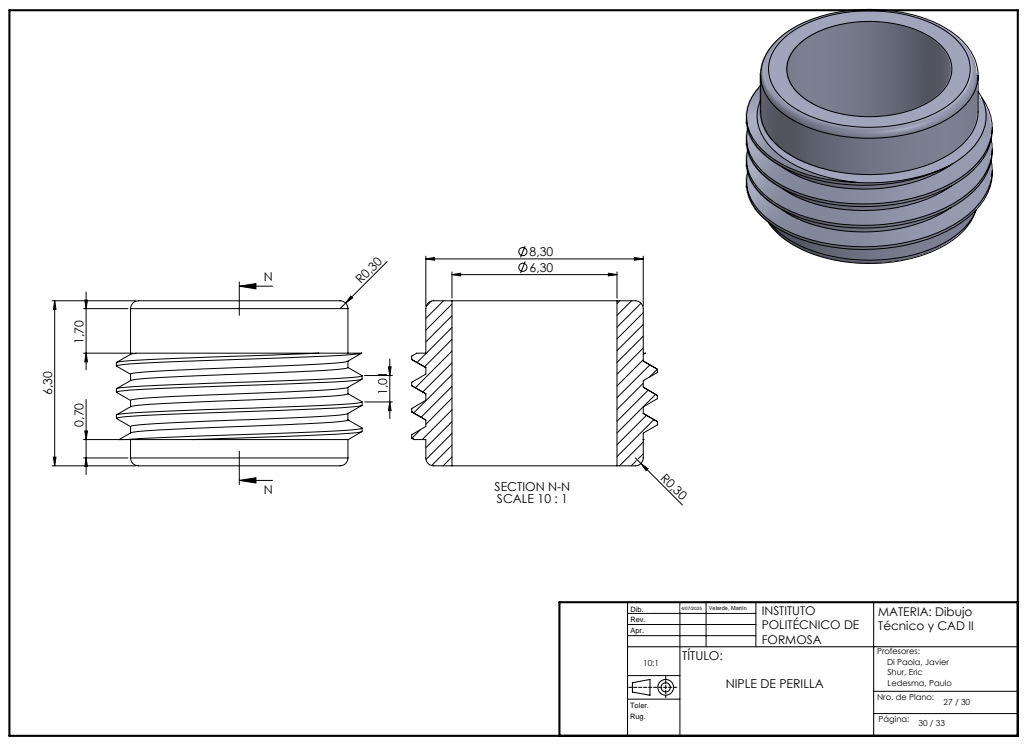
[picture p56: page 27]
SECTION N-N SCALE 10 : 1; POLITÉCNICO DE

MATERIA: Dibujo
Técnico y CAD II

NIPLE DE PERILLA

Di Paola, Javier
Shur, Eric
Ledesma, Paulo
Nro. de Plano:

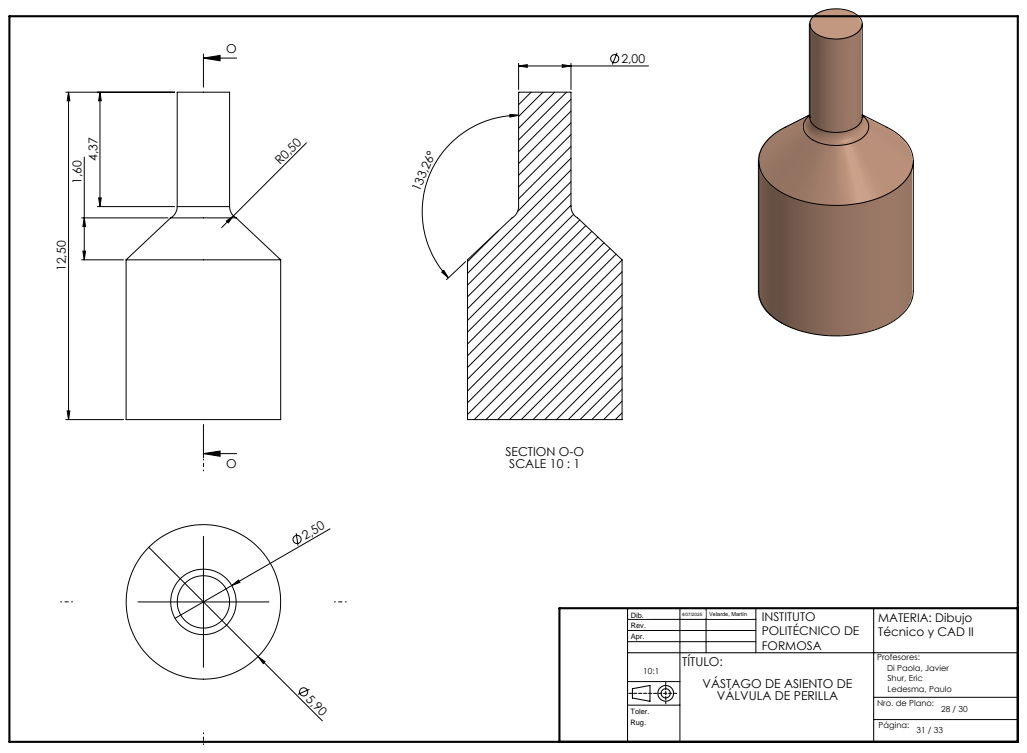
[picture p57: page 28]
SECTION O-O SCALE 10 : 1; POLITÉCNICO DE

MATERIA: Dibujo
Técnico y CAD II

VÁSTAGO DE ASIENTO DE
VÁLVULA DE PERILLA

Di Paola, Javier
Shur, Eric
Ledesma, Paulo
Nro. de Plano:

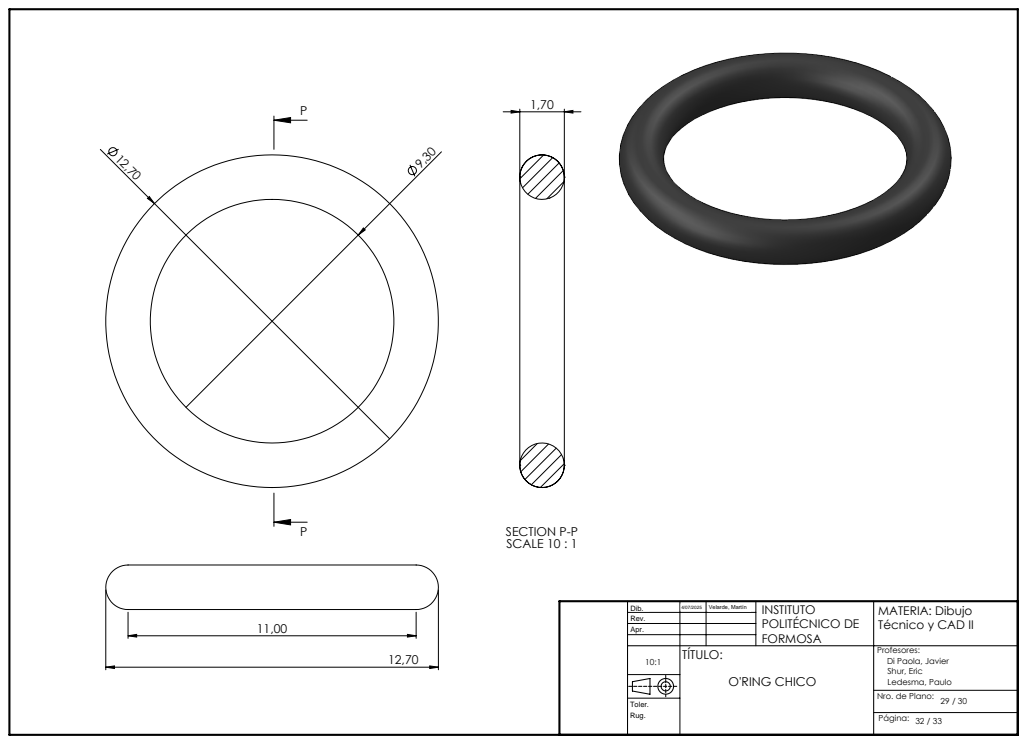
[picture p58: page 29]
SECTION P-P SCALE 10 : 1; O'RING CHICO; POLITÉCNICO DE

MATERIA: Dibujo
Técnico y CAD II

Di Paola, Javier
Shur, Eric
Ledesma, Paulo
Nro. de Plano:

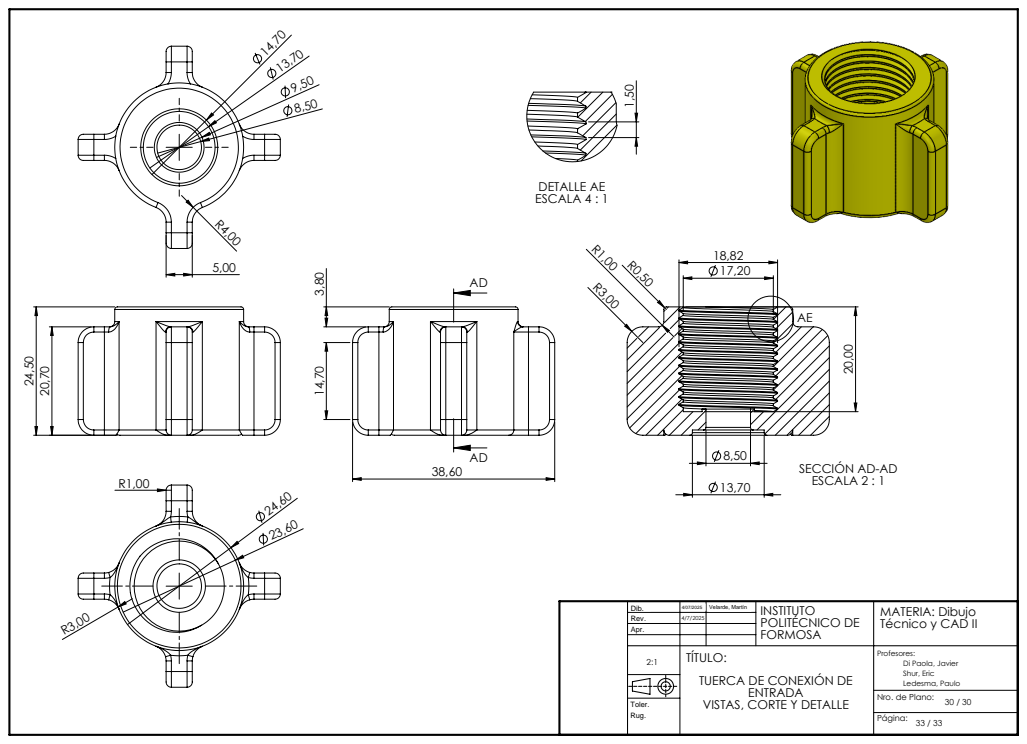
[picture p59: page 30]
DETALLE AE ESCALA 4 : 1; POLITÉCNICO DE; MATERIA: Dibujo

SECCIÓN AD-AD
ESCALA 2 : 1

Técnico y CAD II 4/7/2025

TÍTULO:
TUERCA DE CONEXIÓN DE
ENTRADA
VISTAS, CORTE Y DETALLE

Profesores:
Di Paola, Javier
Shur, Eric
Ledesma, Paulo
Nro. de Plano:
