cadcatcam/caudalimetroO2_velarde/(commit log)

2025-04-24 Se hicieron 3 componentes: esfera, tapon y oring. 24-04-2025 15:59hs
    [esfera.SLDPRT, oring.SLDPRT, tapon.SLDPRT]
2025-04-25 Inicio planos. Se hace plano del tapon. 25-04-2025. 14:03hs
    [tapon.SLDDRW]
2025-05-09 Se avanza en cilindro exterior. 08-05-2025. 21:25hs
    [cilindro_exterior.SLDPRT]
2025-05-12 Apariencias. 12-05-2025. 20:59hs}
    [cilindro_exterior.SLDPRT]
2025-05-19 Se termina cilindro interno, avance cilindro externo y tuerca_capuchon. 19-05-2025. 20:59hs
    [cilindro_exterior.SLDPRT, cilindro_interno.SLDPRT, tuerca_capuchon.SLDPRT]
2025-05-23 Se avanza en cilindro interior con estrias para conectar manguera. 22-05-2025. 21:35hs
    [cilindroConexionManguera.SLDPRT, tuerca_capuchon.IGS, tuerca_capuchon.SLDPRT]
2025-05-26 Subo tapon en igs para intentar abrirlo en la v2018. 26-05-2025. 15:17hs
    [tapon_2018.IGS]
2025-05-26 Se sube tuerca capuchon con rosca mejorada. 26-05-2025. 16:00hs
    [tuerca_capuchon_v2_2020.IGS, tuerca_capuchon_v2_2020.SLDPRT, tuerca_capuchon_v2_2020.STEP]
2025-05-26 Avances en partes: capuchon, estria, etc. 26-05-2025. 20:27hs
    [cilindroConexionManguera.SLDPRT, tuerca_capuchon_v2_2018.SLDPRT, tuerca_y_rosca_asiento_vastago_valvula.SLDPRT, vastago_válvula.SLDPRT]
2025-05-30 Avances en partes de la perilla. 29-05-2025. 21:18hs
    [cilindroConexionManguera.SLDPRT, cilindro_rosca_externa_perilla_válvula.SLDPRT, tornillo_perilla_válvula.SLDPRT, tuerca_de_perilla_valvula.SLDPRT, tuerca_y_rosca_asiento_vastago_valvula.SLDPRT, vastago_asiento_perilla_válvula.SLDPRT]
2025-06-02 Se finaliza tuerca externa de válvula. Y detalles de otros componentes. 02-06-2025. 18:54hs
    [tornillo_perilla_válvula.SLDPRT, tuerca_valvula.SLDPRT]
2025-06-03 Más avances. Se Inicia dibujo de cuerpo central. 02-06-2025. 21:26hs
    [tuerca_y_rosca_externa_intermedia.SLDPRT]
2025-06-09 Se avanza en partes principales. Se hacen ensambles. Faltan planos y detalles. 09-06-2025 20:58hs
    [caudalimetro_cilindros.SLDASM, caudalimetro_perilla.SLDASM, caudalimetro_principal.SLDASM, cilindroConexionMangueraCorta.SLDPRT, tapon_2018.SLDPRT, tuerca_externa_con_nervios.SLDPRT, tuerca_y_rosca_externa_intermedia.SLDPRT]
2025-06-20 Grandes aances. 19-06-2025. 21:42hs
    [caudalimetro_cilindros.SLDASM, caudalimetro_perilla.SLDASM, caudalimetro_perilla.SLDDRW, caudalimetro_principal.SLDASM, caudalimetro_principal.SLDDRW, cilindro_exterior.SLDPRT, cilindro_interno.SLDDRW, cilindro_rosca_externa_perilla_válvula.SLDDRW]
2025-06-26 Se suben avances de del proyecto. Faltan planos y tuerca final. 25-06-2025. 21:15
    [caudalimetro_cilindros.SLDASM, caudalimetro_perilla.SLDASM, caudalimetro_principal.SLDASM, cilindro_exterior.SLDPRT, cilindro_interno.SLDPRT, cilindro_rosca_externa_perilla_válvula.SLDPRT, cuerpo_central.SLDPRT, oring_chico.SLDPRT]
2025-06-27 Se termina modelo 3D. Se inicia con planos. 26-06-2025. 21:46hs
    [Cilindro de conexión entrada.SLDPRT, Cilindro de conexión salida.SLDPRT, Cilindro exterior.SLDPRT, Cilindro interno.SLDPRT, Cuerpo central.SLDPRT, Ensamblaje de cilindros.SLDASM, Niple perilla.SLDPRT, Oring chico.SLDPRT]
2025-06-30 Fin modelo 3d. Avances grandes en planos
    [Ensamblaje de cilindros.SLDASM, Esfera_2020.SLDPRT, caudalimetro_principal.SLDASM, esfera.SLDPRT, esfera_2018.SLDPRT, tapon.SLDDRW, tapon_2018.IGS, tuerca_capuchon.IGS]
2025-07-01 Avances en planos. 30-06-2025. 21:14hs
    [Perilla reguladora.SLDASM, caudalimetro_principal.SLDASM]
2025-07-03 Se avanza en los planos. 03-07-2025. 20:34hs
    [caudalimetro_principal.SLDASM]
2025-07-04 Se termina pdf para presentar tp. 04-07-20225. 19:15hs
